dmitry131131/PumpSystem/Monitor/Readme.md

# Pump system monitor

## Release build

```bash
    cmake -G "Unix Makefiles" -S . -B build/Release -DCMAKE_BUILD_TYPE=Release

    cmake --build build/Release/
```
