dmitry131131/PumpSystem/PumpModule/3DModel/ForPrinting/MainParts.3mf

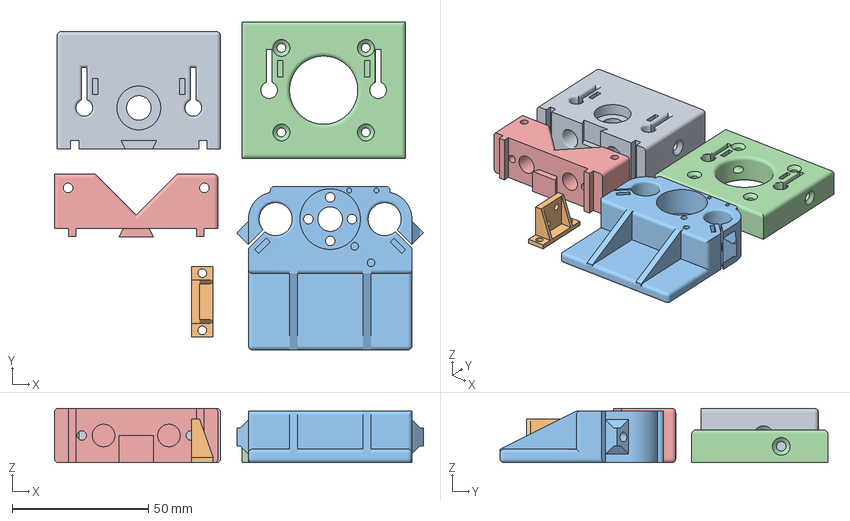
[picture p1: CAD file, 2026-09-05]
PumpModule/3DModel/ForPrinting/MainParts.3mf
135.4 x 120.3 x 20.0 mm
BackMount_magnetic.stp
CableChannelHolder.stp
Carriage_magnetic.stp
EngineMount.stp
MagneticSyringeHolder.stp
