dmitry131131/PumpSystem/MasterModule/3DModel/Под провода.stp

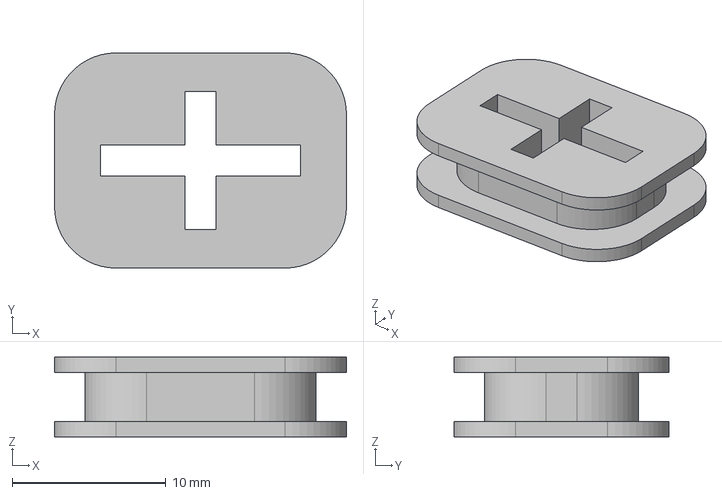
[picture p2: CAD file, 2026-06-11]
MasterModule/3DModel/Под провода.stp
19.0 x 14.0 x 5.20 mm
