dmitry131131/PumpSystem/PumpModule/3DModel/CableChannel/Hinge.STEP

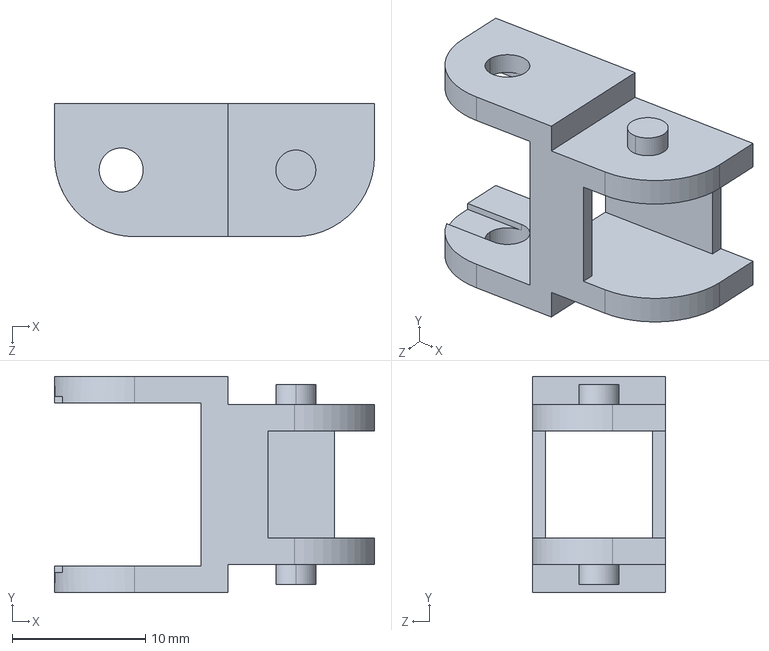
[picture p3: CAD file, 2026-07-20]
PumpModule/3DModel/CableChannel/Hinge.STEP
24.0 x 16.2 x 10.0 mm
