dmitry131131/PumpSystem/PumpModule/3DModel/ForPrinting/SpringeBackHolder.stp

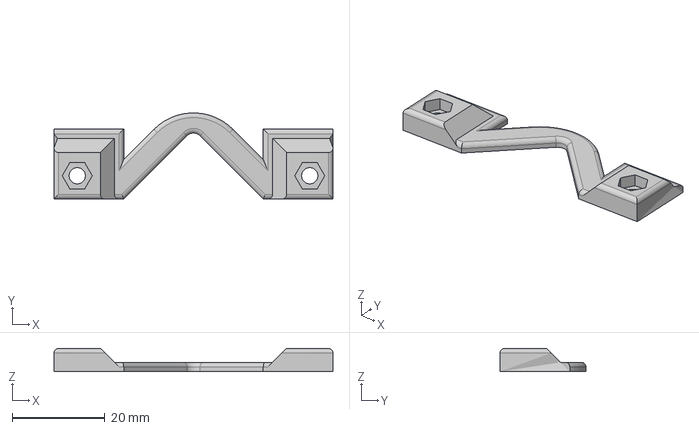
[picture p4: CAD file, 2026-09-05]
PumpModule/3DModel/ForPrinting/SpringeBackHolder.stp
60.0 x 18.5 x 5.00 mm
