dmitry131131/PumpSystem/MasterModule/3DModel/Прижим для UART.stp

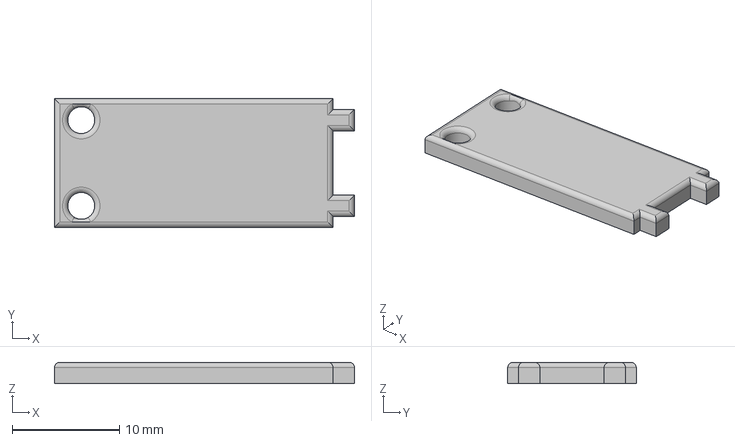
[picture p5: CAD file, 2026-06-11]
MasterModule/3DModel/Прижим для UART.stp
28.0 x 12.0 x 2.00 mm
