dmitry131131/PumpSystem/PumpModule/3DModel/CableChannel/HeadHinge.STEP

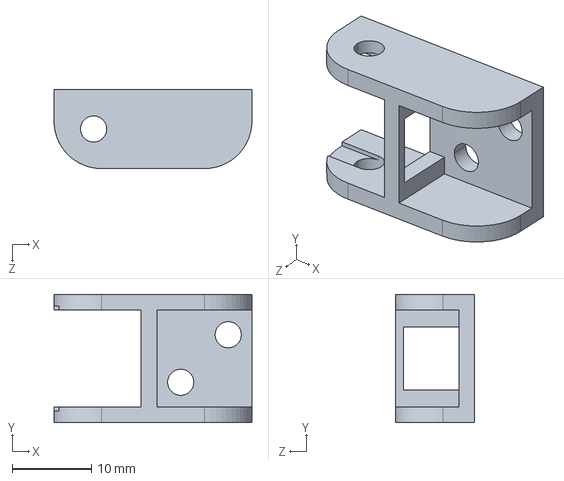
[picture p6: CAD file, 2026-07-20]
PumpModule/3DModel/CableChannel/HeadHinge.STEP
25.0 x 16.2 x 10.0 mm
