dmitry131131/PumpSystem/PumpModule/3DModel/ForPrinting/SyringeHolderHuge.stp

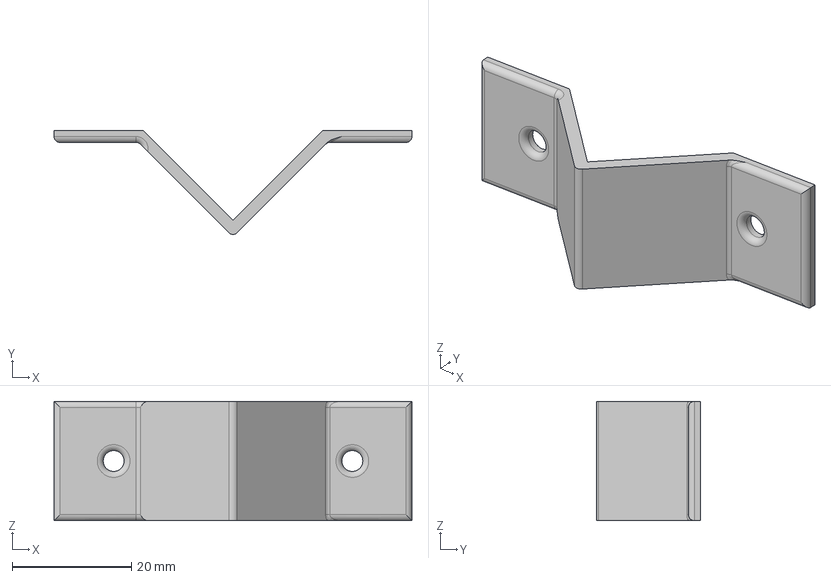
[picture p7: CAD file, 2026-09-05]
PumpModule/3DModel/ForPrinting/SyringeHolderHuge.stp
60.0 x 17.4 x 20.0 mm
