dmitry131131/PumpSystem/MasterModule/3DModel/Главная деталь корпуса.stp

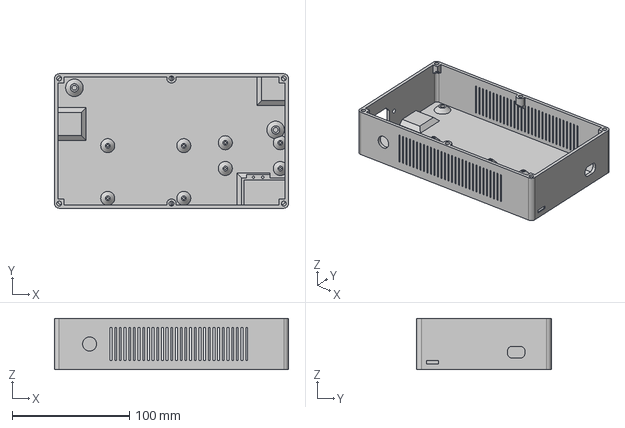
[picture p8: CAD file, 2026-06-11]
MasterModule/3DModel/Главная деталь корпуса.stp
200.0 x 115.0 x 44.0 mm
