dmitry131131/PumpSystem/PumpModule/3DModel/CableChannel/TailHinge.STEP

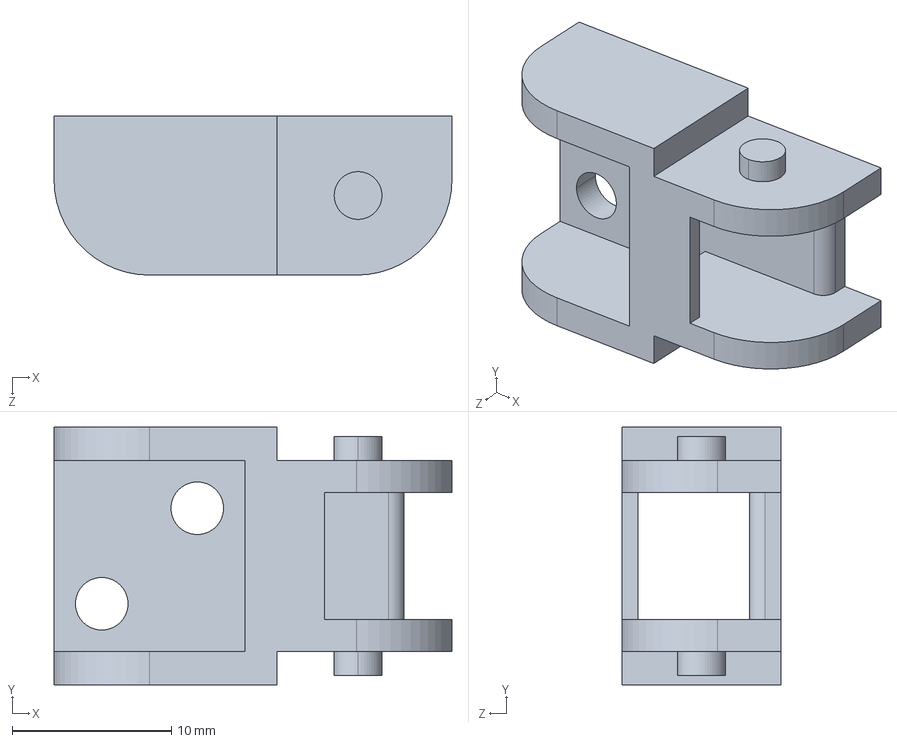
[picture p9: CAD file, 2026-07-20]
PumpModule/3DModel/CableChannel/TailHinge.STEP
25.0 x 16.2 x 10.0 mm
