dmitry131131/PumpSystem/MasterModule/3DModel/Крышка.stp

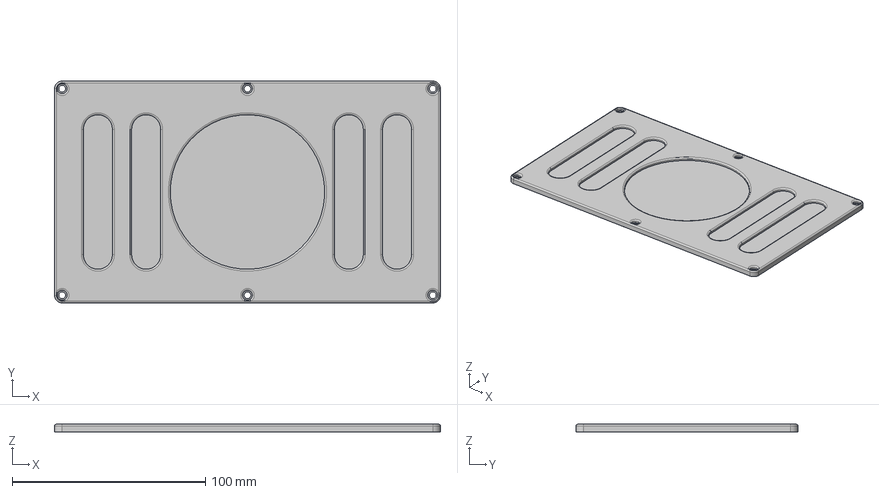
[picture p10: CAD file, 2026-06-11]
MasterModule/3DModel/Крышка.stp
200.0 x 115.0 x 4.00 mm
