dmitry131131/PumpSystem/PumpModule/3DModel/ForPrinting/SyringeHolderSmall.stp

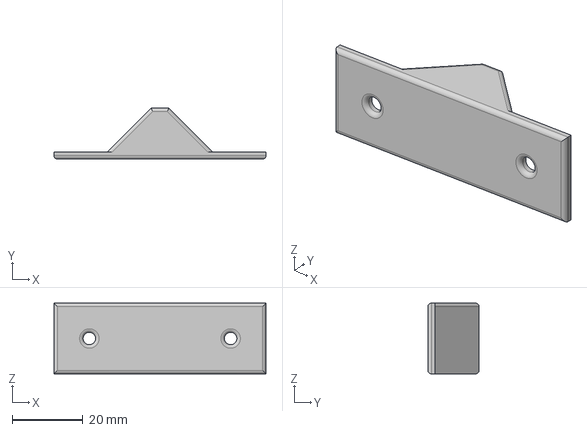
[picture p11: CAD file, 2026-09-05]
PumpModule/3DModel/ForPrinting/SyringeHolderSmall.stp
60.0 x 14.5 x 20.0 mm
