dmitry131131/PumpSystem/PumpModule/3DModel/ForPrinting/ElectricBox.stp

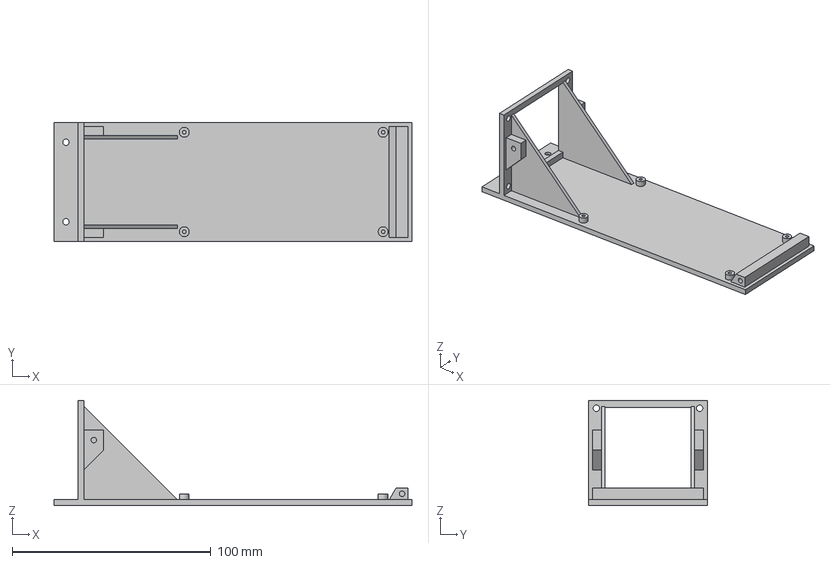
[picture p12: CAD file, 2026-09-05]
PumpModule/3DModel/ForPrinting/ElectricBox.stp
180.0 x 60.0 x 53.0 mm
