dmitry131131/PumpSystem/PumpModule/3DModel/ForPrinting/SyringeHolderMedium.stp

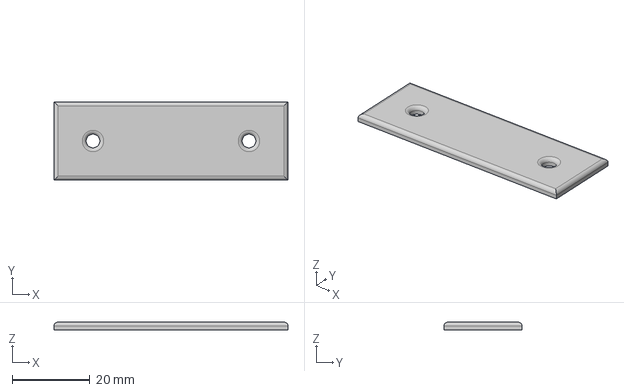
[picture p13: CAD file, 2026-09-05]
PumpModule/3DModel/ForPrinting/SyringeHolderMedium.stp
60.0 x 20.0 x 2.00 mm
