dmitry131131/PumpSystem/PumpModule/3DModel/ForPrinting/Stoper.stp

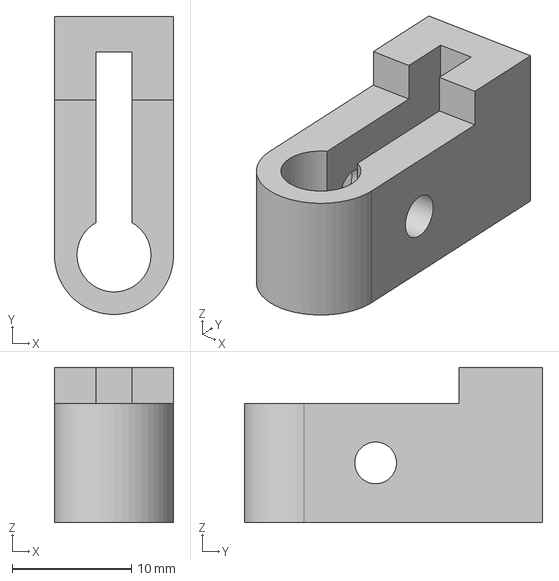
[picture p14: CAD file, 2026-09-05]
PumpModule/3DModel/ForPrinting/Stoper.stp
10.0 x 25.0 x 13.0 mm
