dmitry131131/PumpSystem/PumpModule/3DModel/ForPrinting/BackMount_magnetic.stp

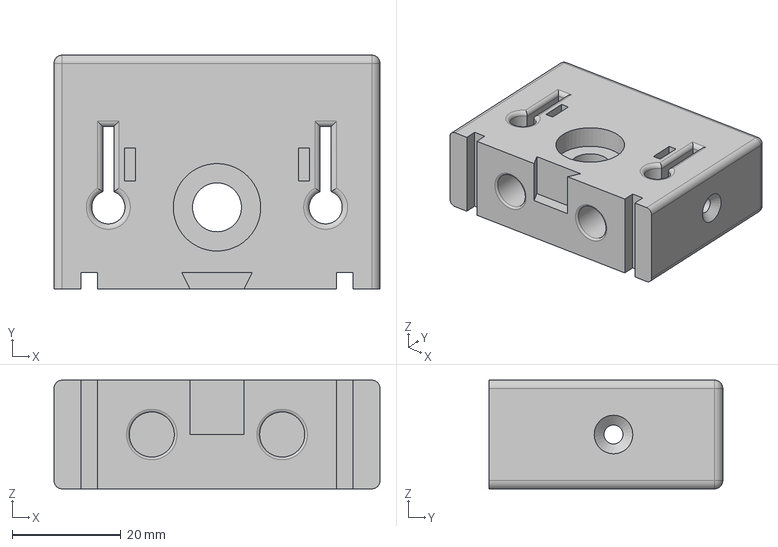
[picture p15: CAD file, 2026-09-05]
PumpModule/3DModel/ForPrinting/BackMount_magnetic.stp
60.0 x 43.0 x 20.0 mm
