dmitry131131/PumpSystem/PumpModule/3DModel/ForPrinting/CableChannel.3mf

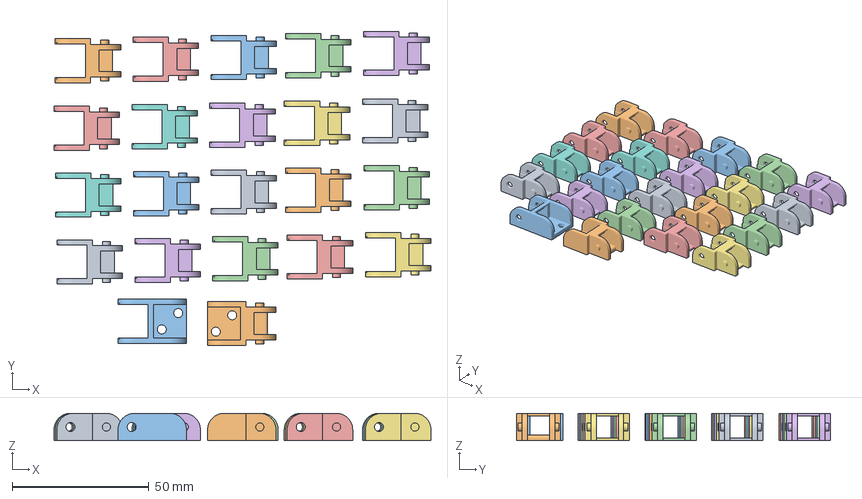
[picture p16: CAD file, 2026-09-05]
PumpModule/3DModel/ForPrinting/CableChannel.3mf
137.9 x 115.0 x 10.0 mm
Hinge.STEP x 20
TailHinge.STEP
HeadHinge.STEP
