dmitry131131/PumpSystem/PumpModule/3DModel/ForPrinting/SupportingElements.3mf

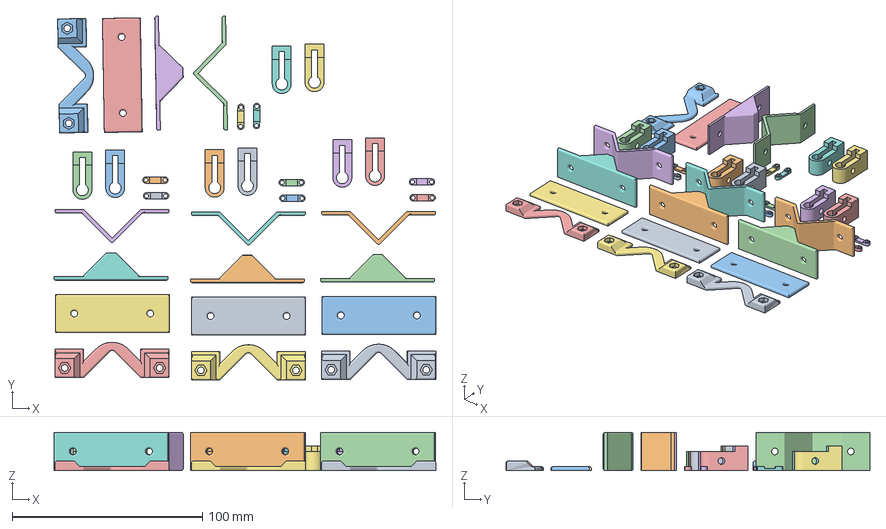
[picture p17: CAD file, 2026-09-05]
PumpModule/3DModel/ForPrinting/SupportingElements.3mf
200.9 x 191.4 x 20.0 mm
SpringeBackHolder.stp x 4
SyringeHolderHuge.stp x 4
SyringeHolderMedium.stp x 4
SyringeHolderSmall.stp x 4
WireHolder.stp x 8
Stoper.stp x 8
