dmitry131131/PumpSystem/PumpModule/3DModel/ForPrinting/ElectricBoxCup.stp

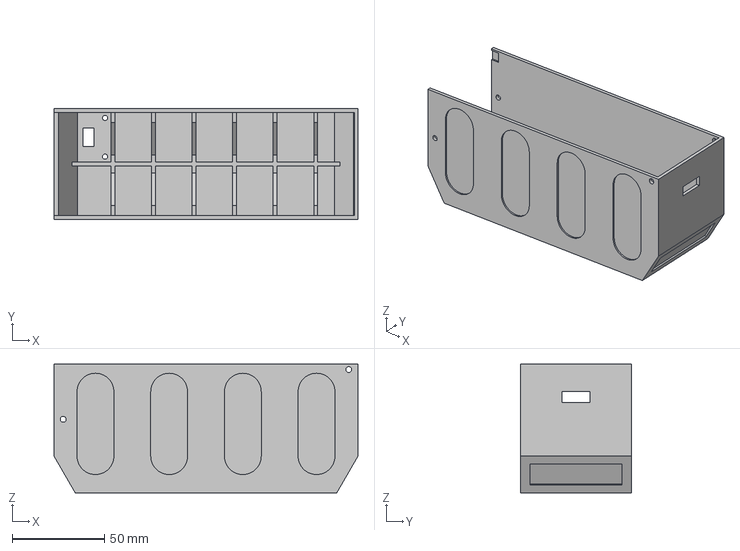
[picture p18: CAD file, 2026-09-05]
PumpModule/3DModel/ForPrinting/ElectricBoxCup.stp
165.0 x 60.0 x 70.0 mm
