dmitry131131/PumpSystem/PumpModule/3DModel/ForPrinting/EngineMount.stp

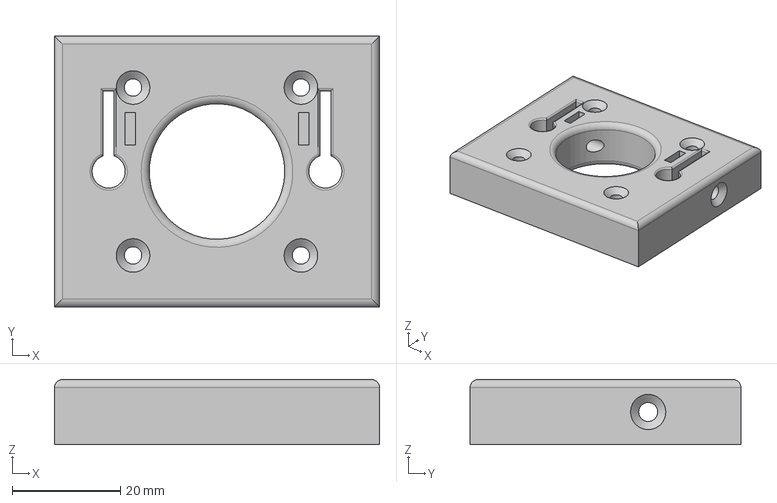
[picture p19: CAD file, 2026-09-05]
PumpModule/3DModel/ForPrinting/EngineMount.stp
60.0 x 50.0 x 12.0 mm
