dmitry131131/PumpSystem/PumpModule/3DModel/ForPrinting/WireHolder.stp

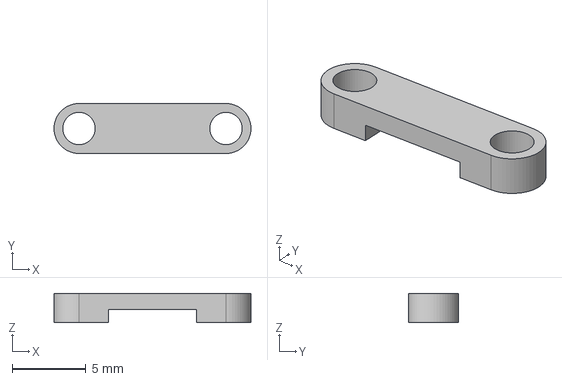
[picture p20: CAD file, 2026-07-20]
PumpModule/3DModel/ForPrinting/WireHolder.stp
13.4 x 3.40 x 2.00 mm
