dmitry131131/PumpSystem/PumpModule/3DModel/ForPrinting/Carriage_magnetic.stp

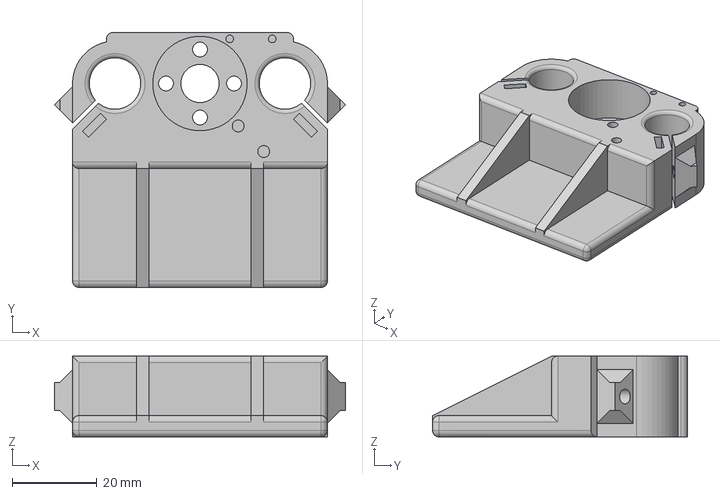
[picture p21: CAD file, 2026-07-20]
PumpModule/3DModel/ForPrinting/Carriage_magnetic.stp
68.5 x 60.0 x 19.0 mm
