dmitry131131/PumpSystem/PumpModule/3DModel/ForPrinting/MagneticSyringeHolder.stp

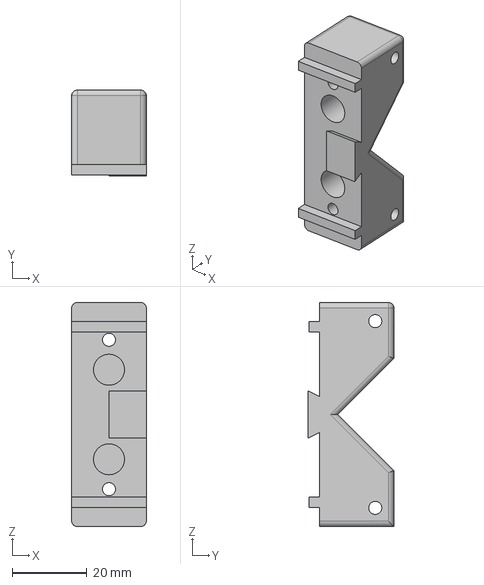
[picture p22: CAD file, 2026-07-20]
PumpModule/3DModel/ForPrinting/MagneticSyringeHolder.stp
20.0 x 23.0 x 60.0 mm
