dmitry131131/PumpSystem/PumpModule/3DModel/ForPrinting/CableChannelHolder.stp

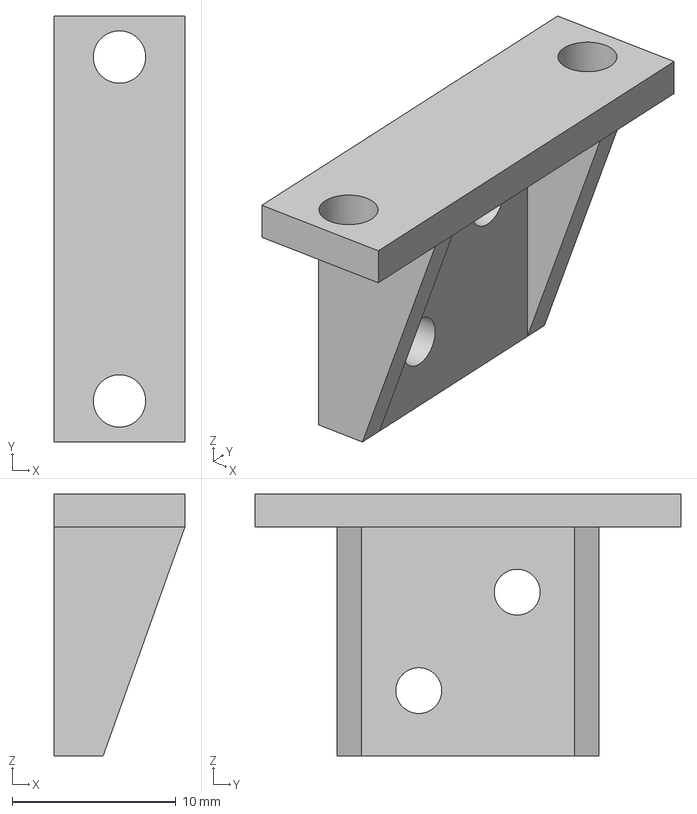
[picture p23: CAD file, 2026-07-20]
PumpModule/3DModel/ForPrinting/CableChannelHolder.stp
8.00 x 26.0 x 16.0 mm
