dmitry131131/PumpSystem/(list of files, cad)

Other CAD files:
MasterModule/3DModel/Главная деталь корпуса.3mf
MasterModule/3DModel/Крышка.3mf
MasterModule/3DModel/Под провода.3mf
PumpModule/3DModel/ForPrinting/BoltCap.3mf
PumpModule/3DModel/ForPrinting/BoltCap.stp
PumpModule/3DModel/ForPrinting/ElectricBox.3mf
PumpModule/3DModel/ForPrinting/Stoper.3mf
