dmitry131131/PumpSystem/PumpModule/3DModel/CableChannel/BuildExample.PNG

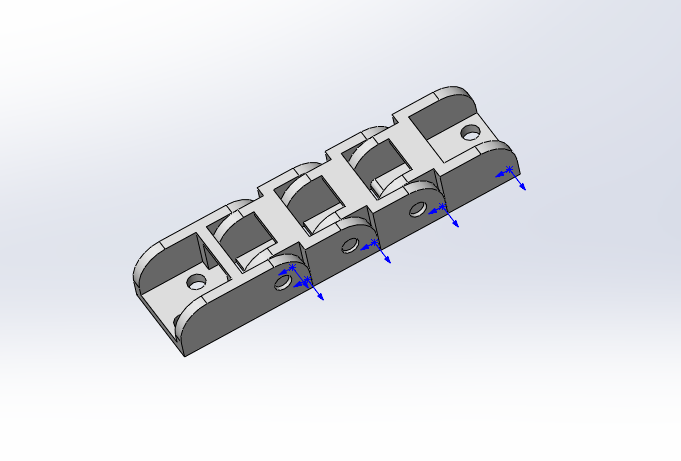
PumpModule/3DModel/CableChannel/BuildExample.PNG
