dmitry131131/PumpSystem/MasterModule/PCB/Bus/BusModule/_restore_backup_2026-05-27T22-22-10-652/BusModule-B_Cu.pdf

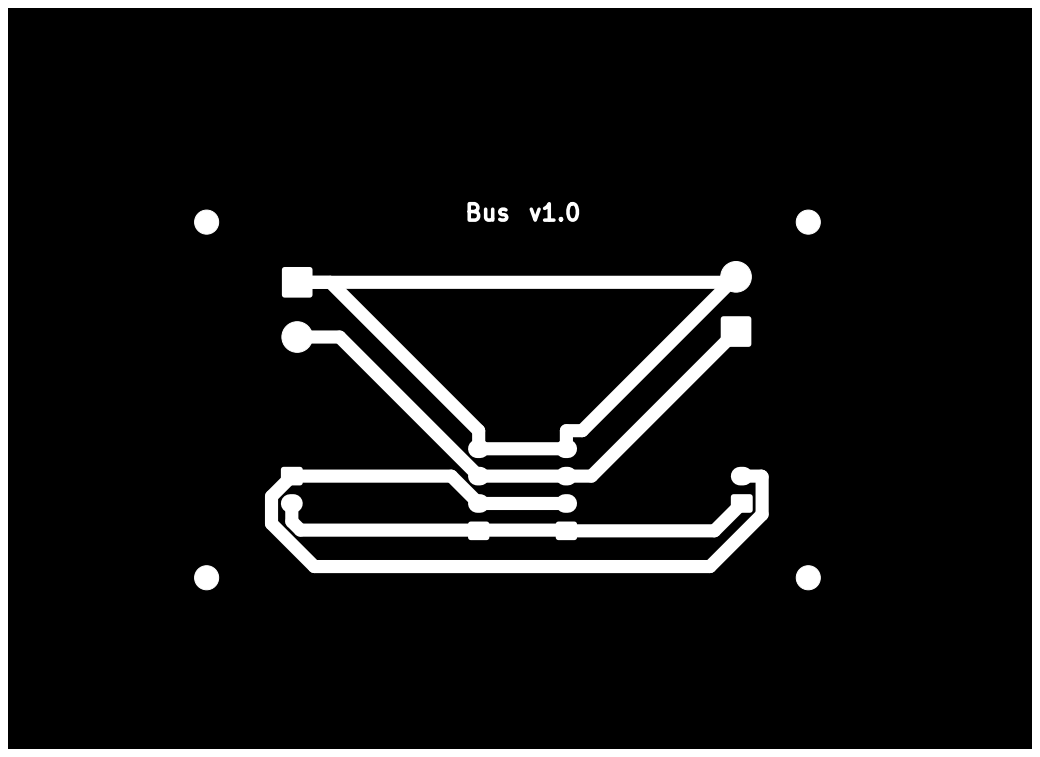
[picture p25: page 1]

Size: A4 | Rev:
KiCad E.D.A. 10.0.3 | Id: 1/1
