dmitry131131/PumpSystem/PumpModule/PCB/Manufacturing/PumpModule-B_Cu.pdf

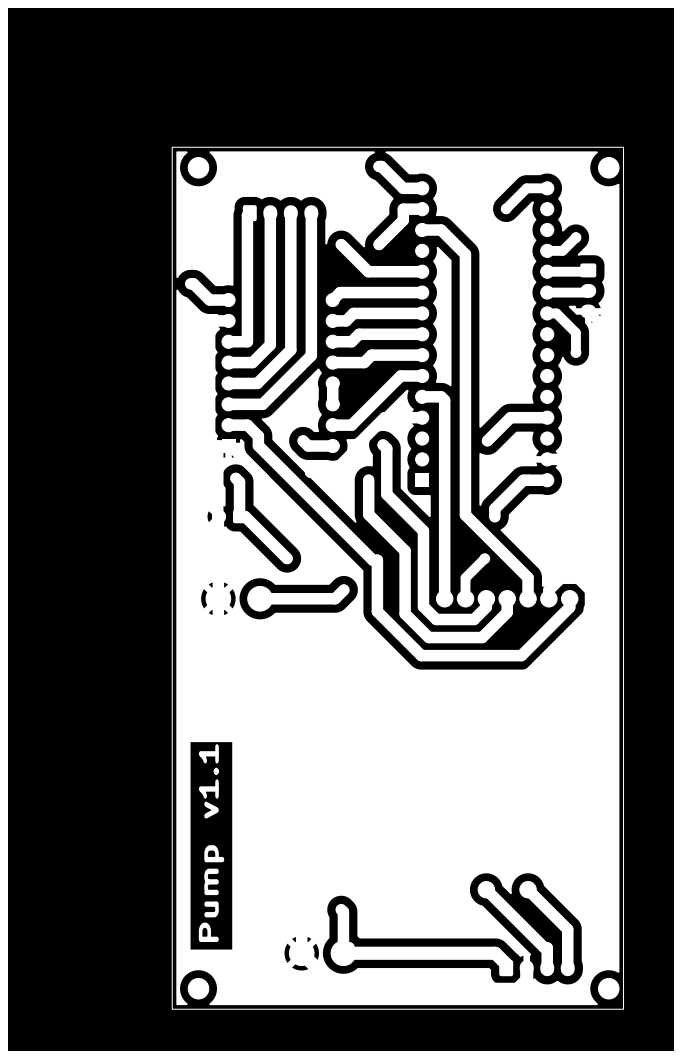
[picture p26: page 1]
