dmitry131131/PumpSystem/PumpModule/PCB/Manufacturing/PumpModule-B_Mask.pdf

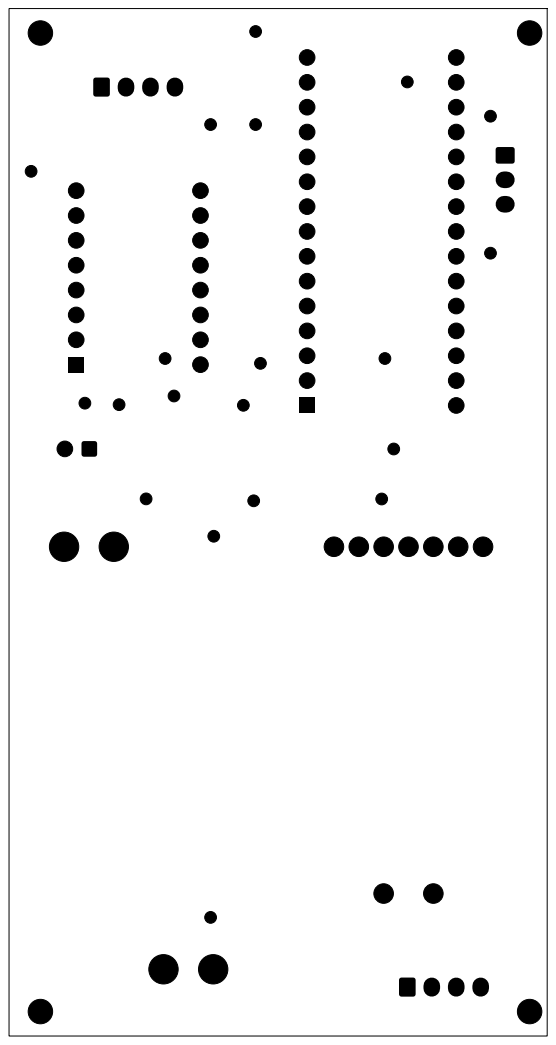
[picture p27: page 1]
