dmitry131131/PumpSystem/PumpModule/PCB/Manufacturing/PumpModule-F_Cu.pdf

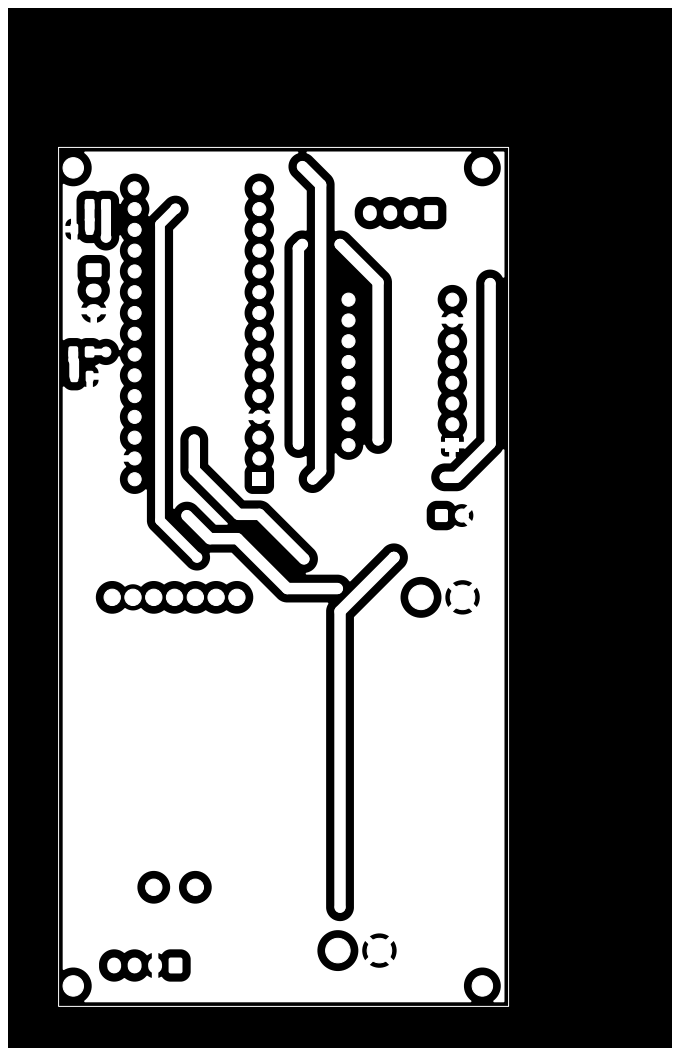
[picture p28: page 1]
