dmitry131131/PumpSystem/PumpModule/PCB/Manufacturing/PumpModule-F_Mask.pdf

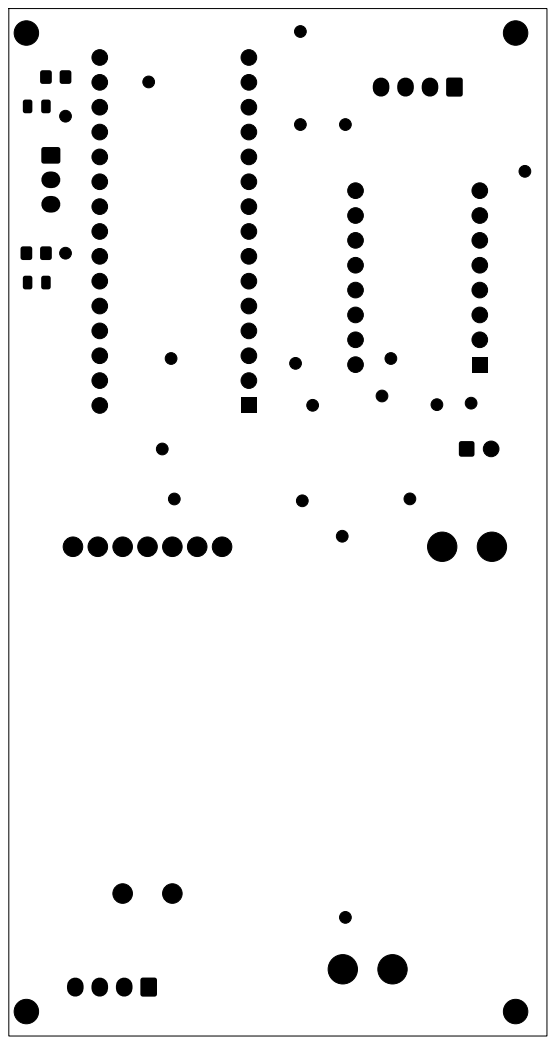
[picture p29: page 1]
