dmitry131131/PumpSystem/PumpModule/PCB/Manufacturing/PumpModule-F_Silkscreen.pdf

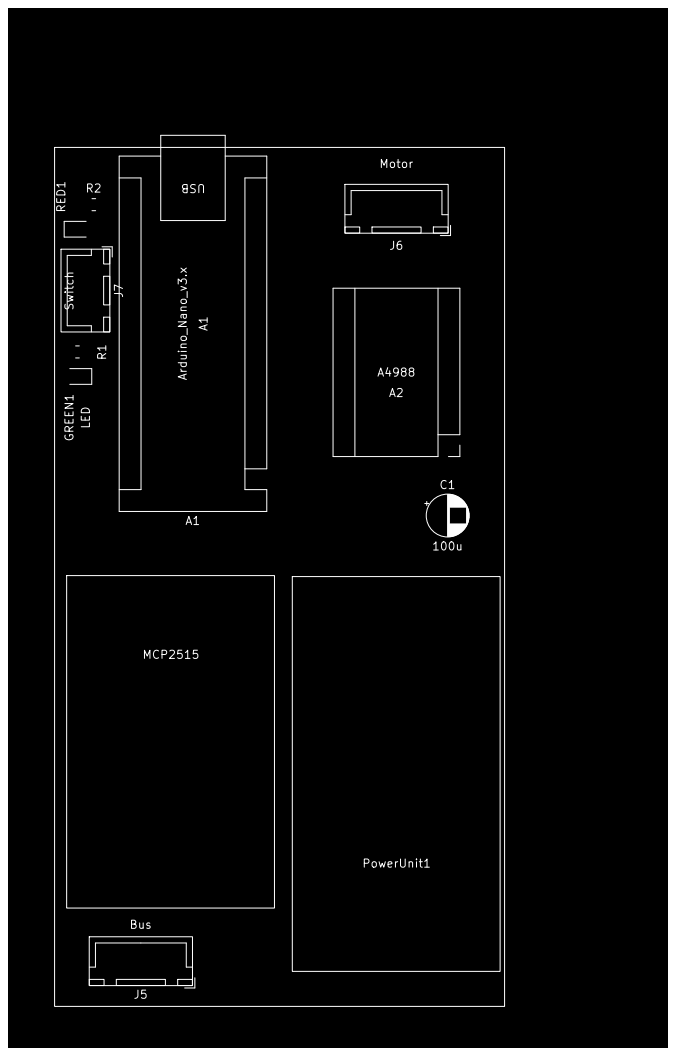
[picture p30: page 1]
