dmitry131131/PumpSystem/PumpModule/PCB/Switch/Manufacturing/Switch-B_Cu.pdf

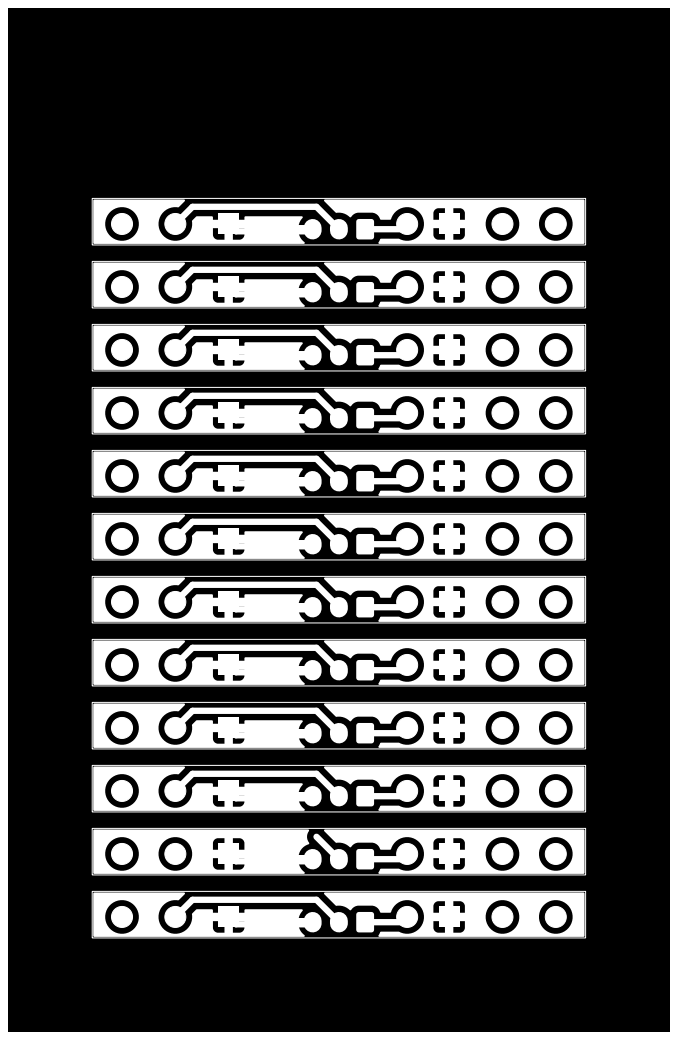
[picture p31: page 1]
