dmitry131131/PumpSystem/PumpModule/PCB/Switch/Manufacturing/Switch-B_Mask.pdf

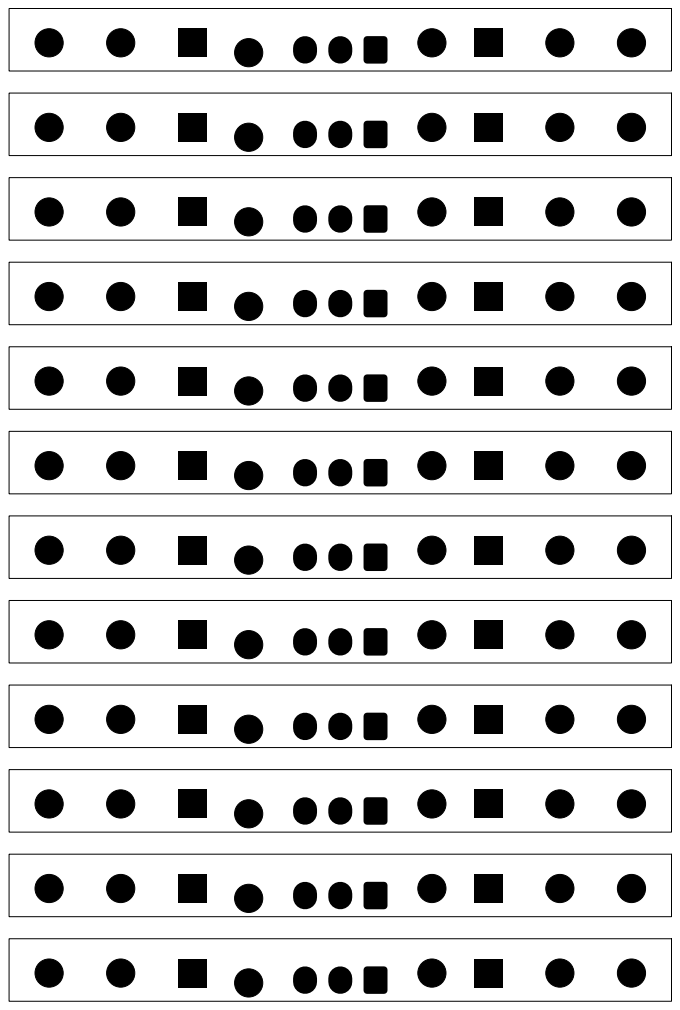
[picture p32: page 1]
