dmitry131131/PumpSystem/PumpModule/PCB/Switch/Manufacturing/Switch-F_Cu.pdf

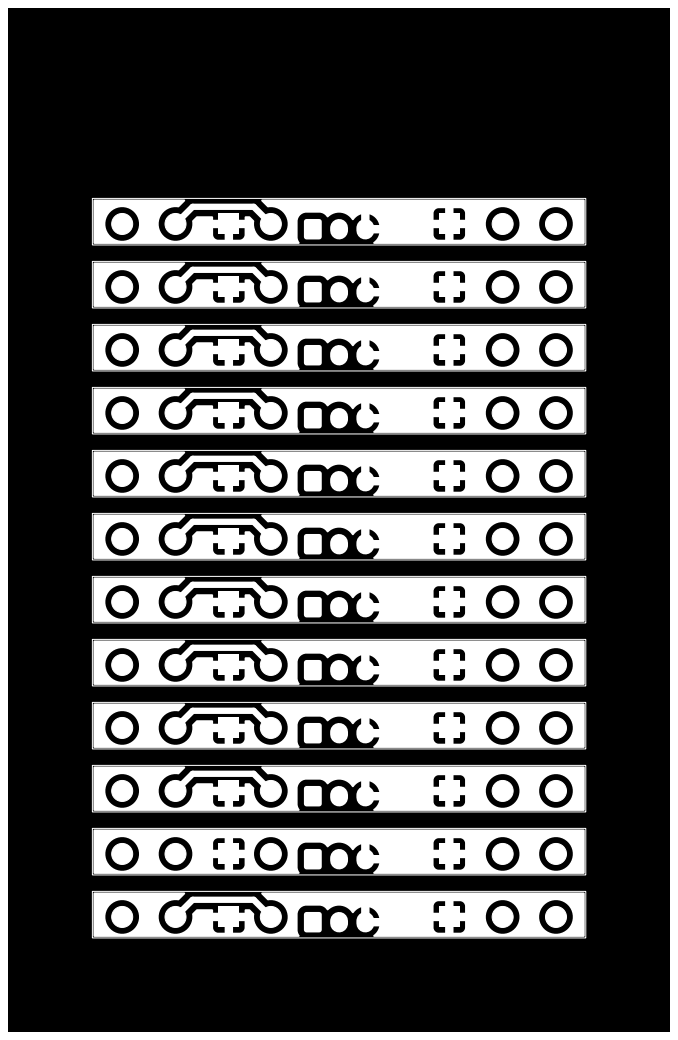
[picture p33: page 1]
