dmitry131131/PumpSystem/PumpModule/PCB/Switch/Manufacturing/Switch-F_Mask.pdf

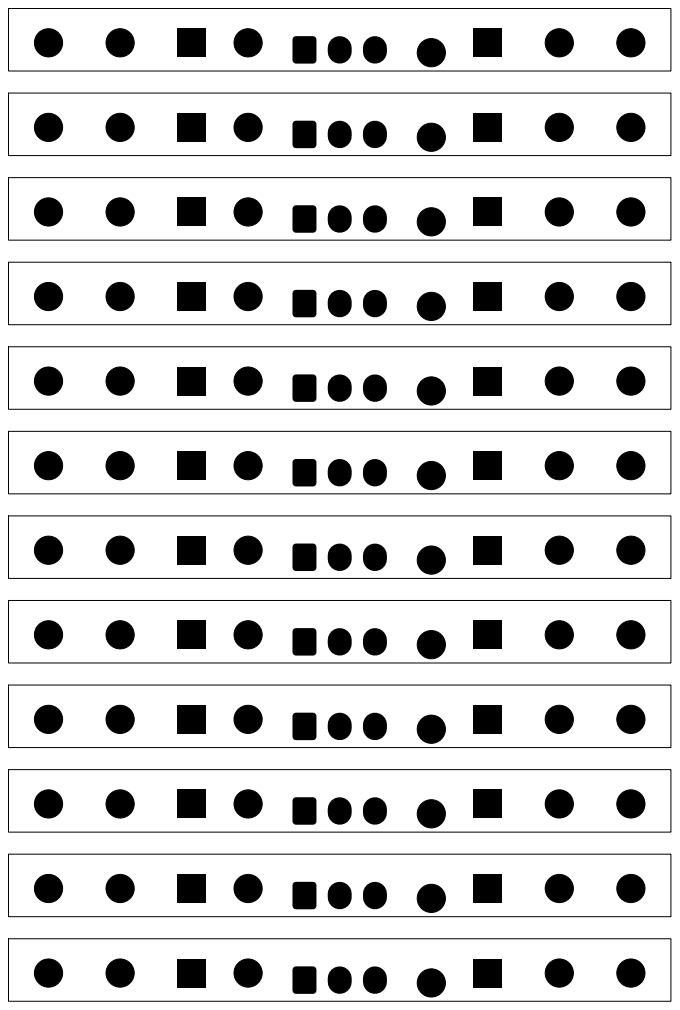
[picture p34: page 1]
