dmitry131131/PumpSystem/MasterModule/PCB/MasterModule/Manufacturing v1.1/MasterModule-B_Cu.pdf

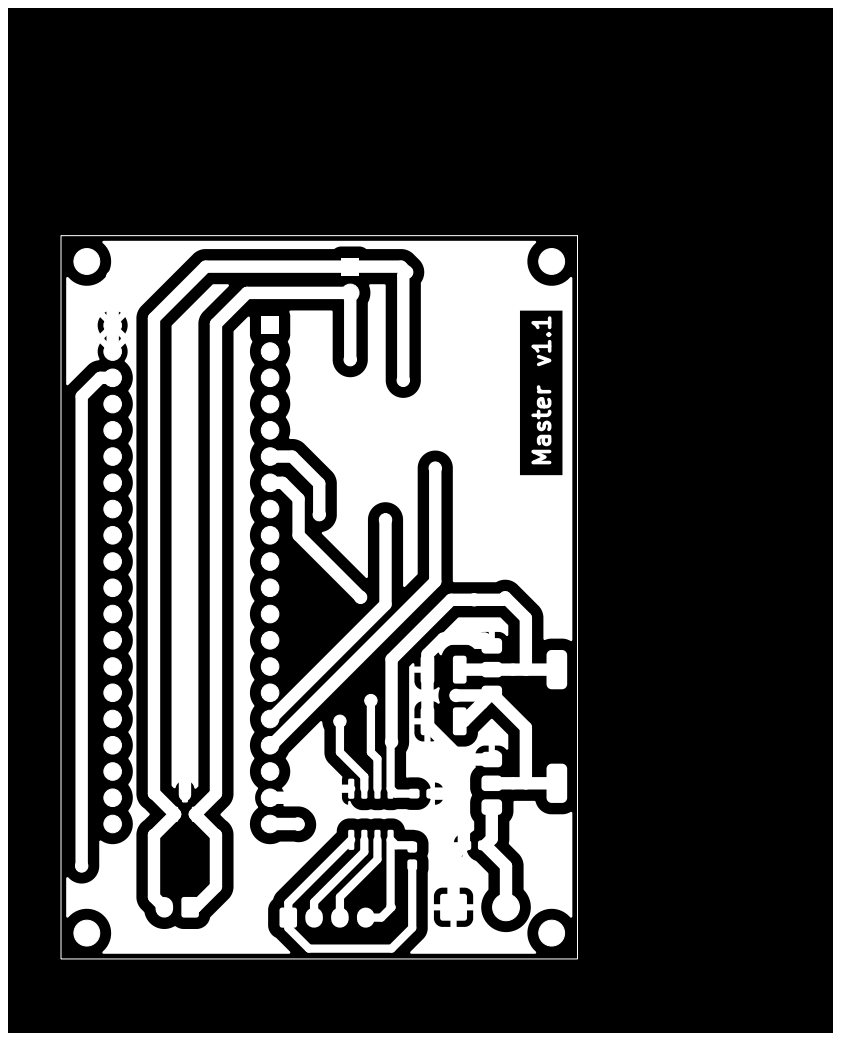
[picture p35: page 1]
