dmitry131131/PumpSystem/MasterModule/PCB/MasterModule/Manufacturing v1.1/MasterModule-F_Cu.pdf

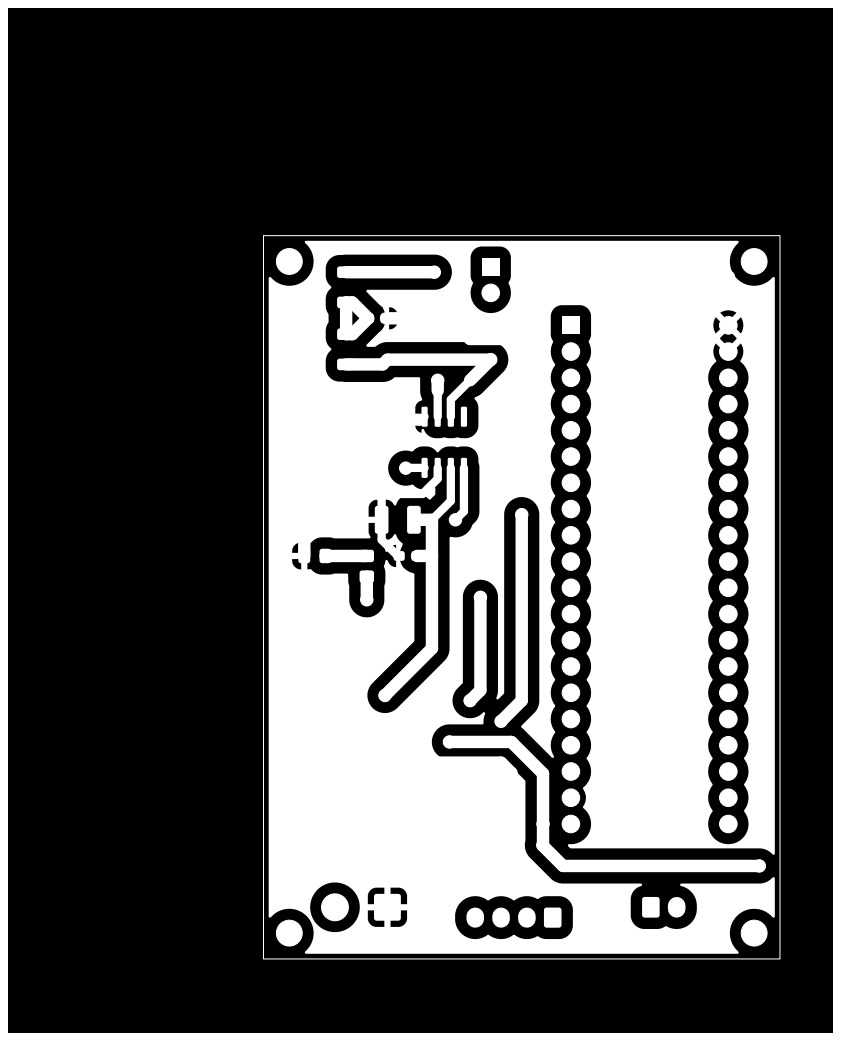
[picture p36: page 1]
