dmitry131131/PumpSystem/MasterModule/PCB/Bus/BusModule/Manufacturing/BusModule-B_Cu.pdf

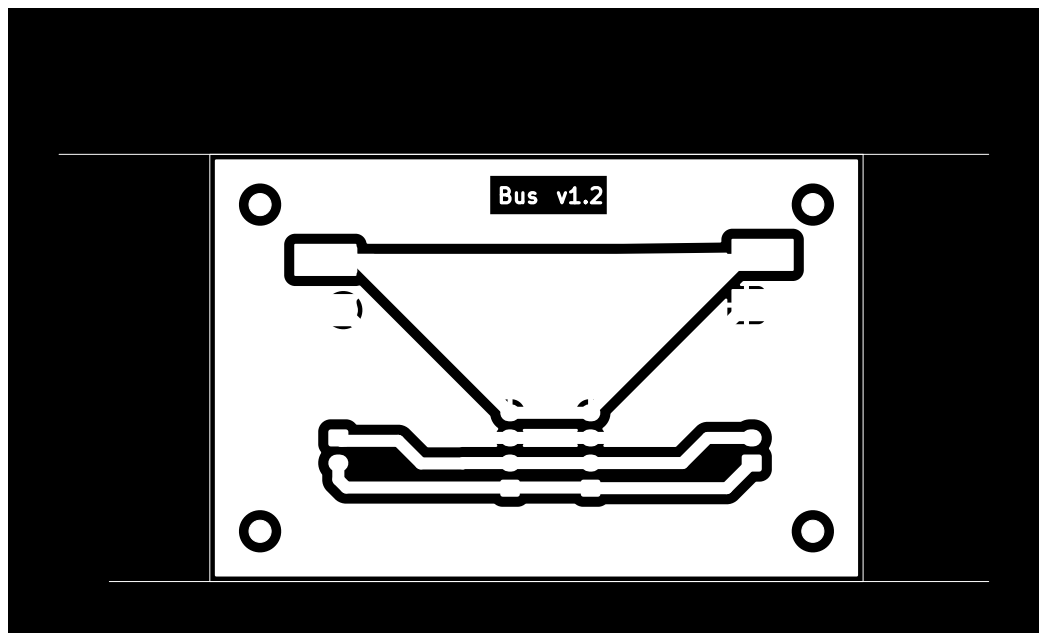
[picture p37: page 1]
