dmitry131131/PumpSystem/MasterModule/PCB/Bus/BusModule/Manufacturing/BusModule-B_Mask.pdf

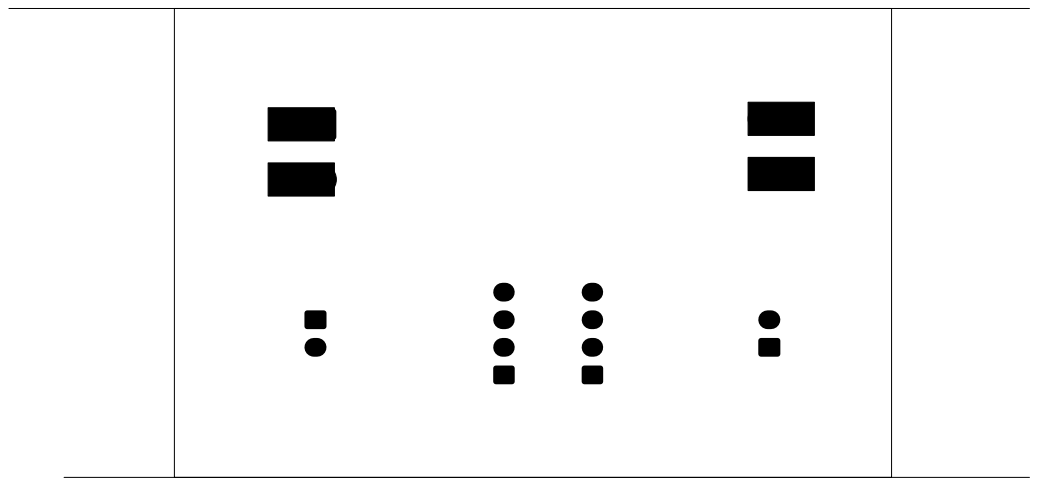
[picture p38: page 1]
