dmitry131131/PumpSystem/MasterModule/PCB/Bus/BusModule/Manufacturing/BusModule-F_Silkscreen.pdf

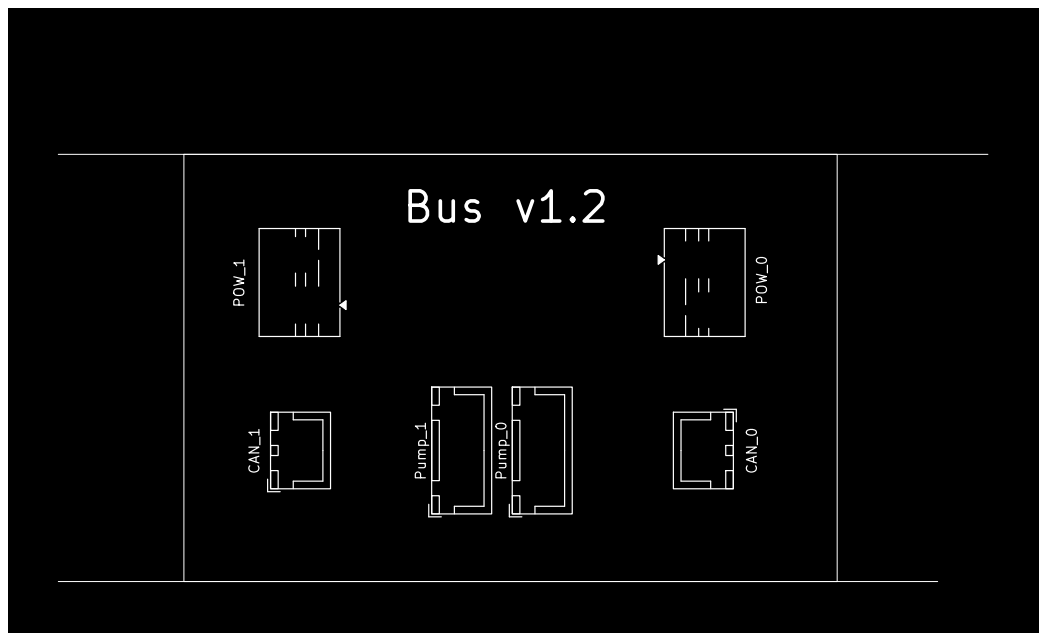
[picture p39: page 1]
