dmitry131131/PumpSystem/MasterModule/PCB/Bus/BusModule/_restore_backup_2026-05-27T22-22-10-652/Manufacturing/BusModule-B_Cu.pdf

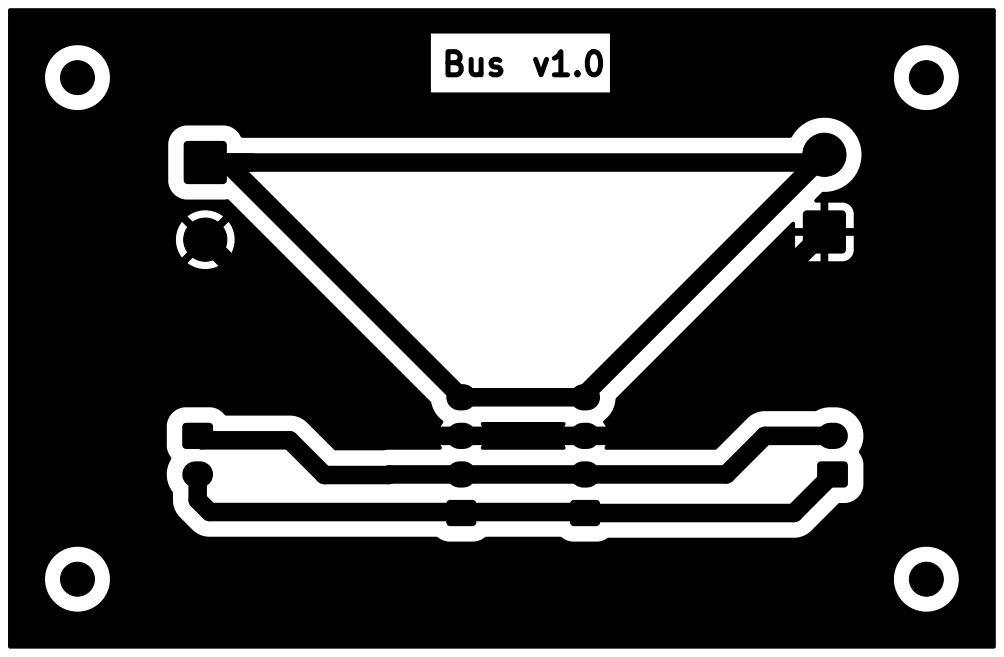
[picture p40: page 1]
