dmitry131131/PumpSystem/MasterModule/PCB/Bus/BusModule/_restore_backup_2026-05-27T22-22-10-652/Manufacturing/BusModule-F_Silkscreen.pdf

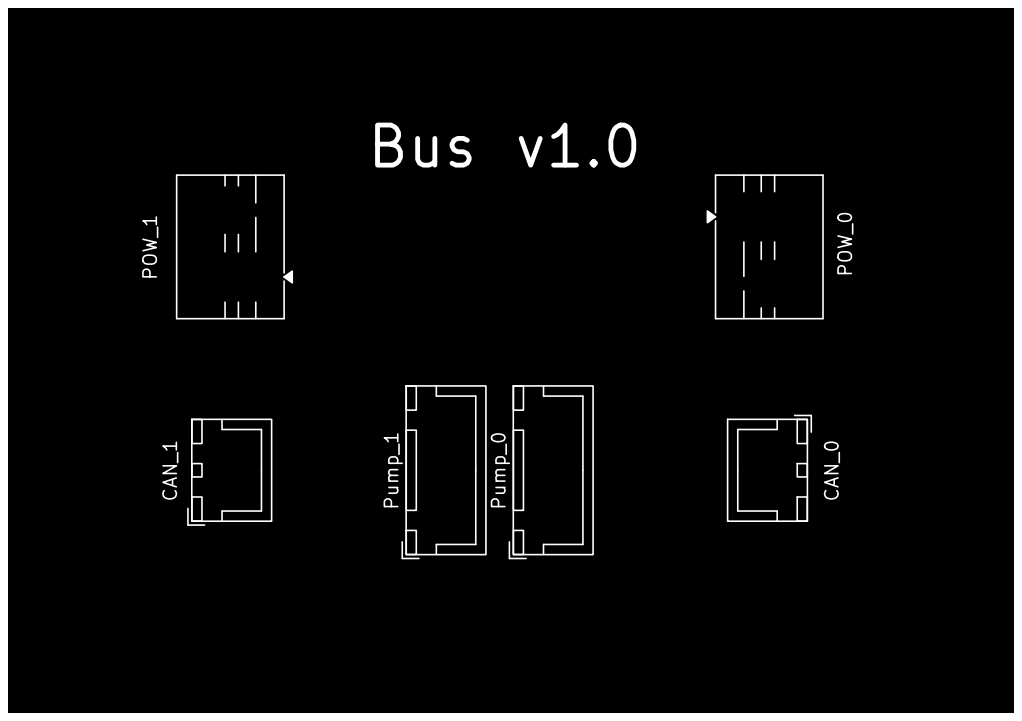
[picture p42: page 1]
