dmitry131131/PumpSystem/MasterModule/PCB/Bus/BusModule/Manufacturing/Bus v1.1 pair/BusModule-B_Cu.pdf

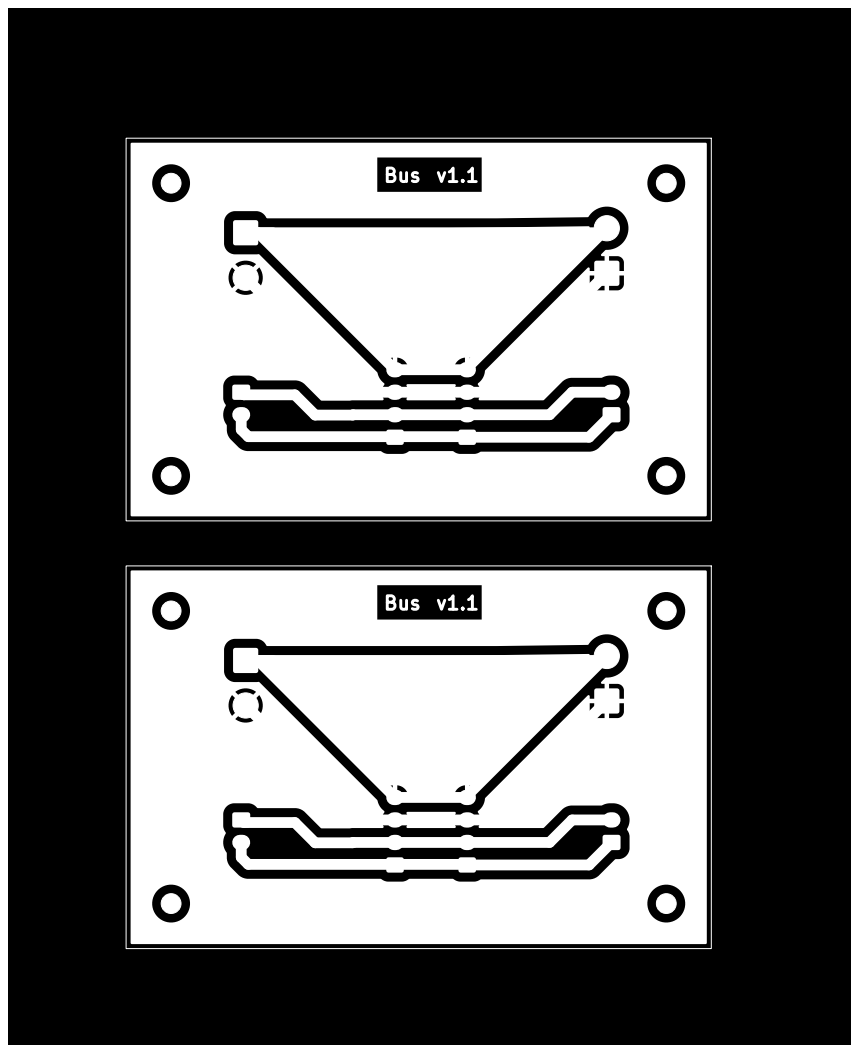
[picture p43: page 1]
