dmitry131131/PumpSystem/MasterModule/PCB/Bus/BusModule/Manufacturing/Bus v1.1 pair/BusModule-B_Mask.pdf

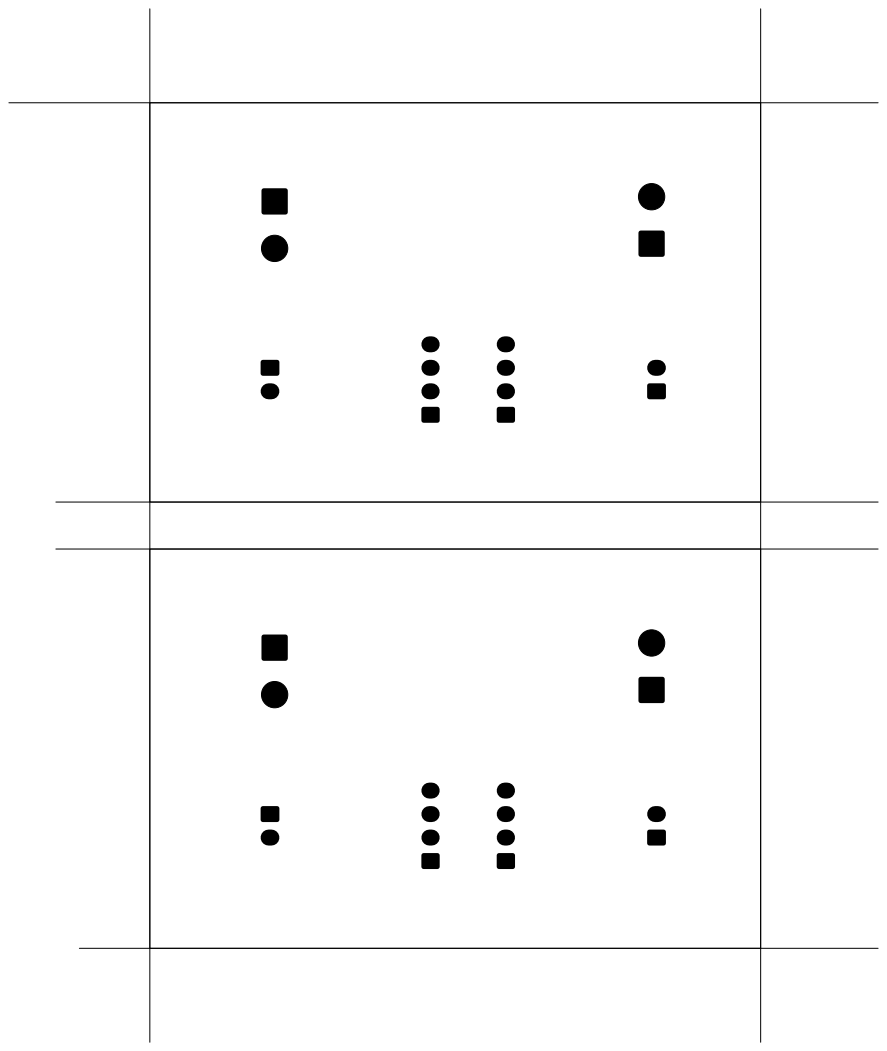
[picture p44: page 1]
