dmitry131131/PumpSystem/MasterModule/PCB/Bus/BusModule/Manufacturing/Bus v1.1 pair/BusModule-F_Silkscreen.pdf

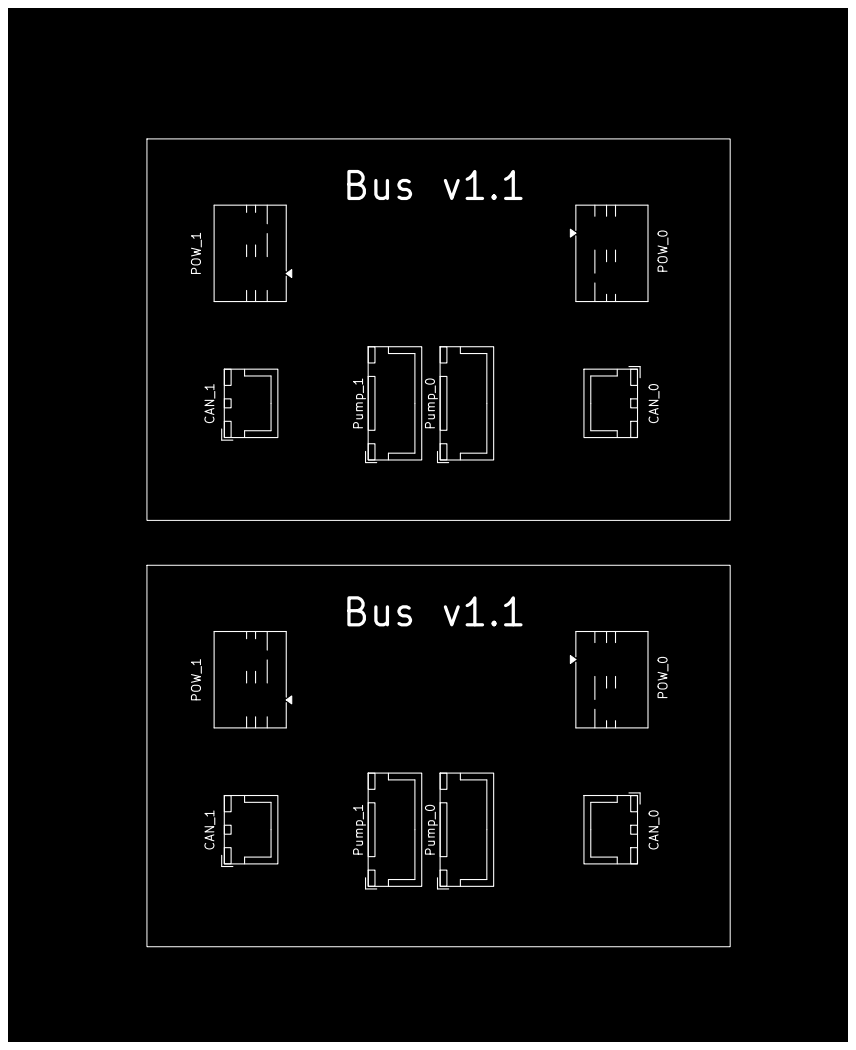
[picture p45: page 1]
