dmitry131131/PumpSystem/PumpModule/PCB/PumpModule/PumpModule.kicad_pcb

## KiCad design PumpModule/PCB/PumpModule/PumpModule.kicad_pcb (2026-09-05)

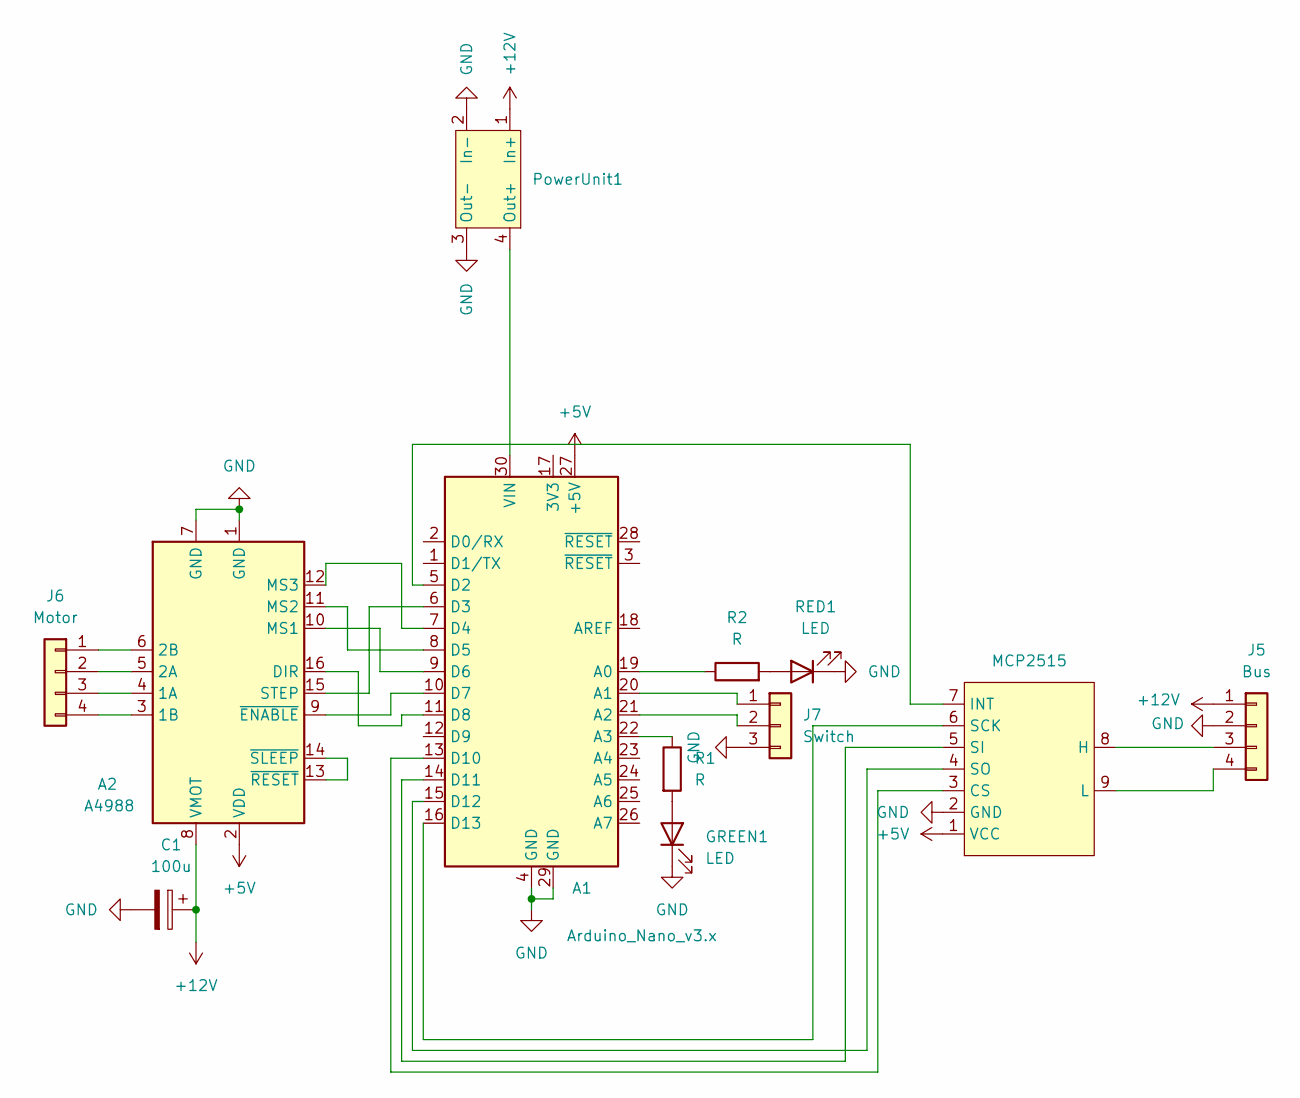
[picture p46: schematic PumpModule.kicad_sch]

Parts:
A1: Arduino_Nano_v3.x; Arduino_Nano
A2: A4988; Pololu_Breakout-16_15.2x20.3mm
C1: 100u; CP_Radial_D5.0mm_P2.50mm
GREEN1: LED; LED_0805_2012Metric
J5: Bus; JST_XH_B4B-XH-A_1x04_P2.50mm_Vertical
J6: Motor; JST_XH_B4B-XH-A_1x04_P2.50mm_Vertical
J7: Switch; JST_XH_B3B-XH-A_1x03_P2.50mm_Vertical
MCP2515: MCP2515Mudule
PowerUnit1: DC-DC_Low
R1, R2: R; R_0805_2012Metric_Pad1.20x1.40mm_HandSolder
RED1: LED; LED_0805_2012Metric

Connections:
+5V: A1.27 (+5V), A2.2 (VDD), MCP2515.1 (VCC)
+12V: A2.8 (VMOT), C1.1, J5.1, PowerUnit1.1 (In+)
GND: A1.4 (GND), A1.29 (GND), A2.1 (GND), A2.7 (GND), C1.2, GREEN1.1 (K), J5.2, J7.3, MCP2515.2 (GND), PowerUnit1.2 (In-), PowerUnit1.3 (Out-), RED1.1 (K)
unnamed: A1.19 (A0), R2.1
unnamed: A1.20 (A1), J7.1
unnamed: A1.21 (A2), J7.2
unnamed: A1.22 (A3), R1.1
unnamed: A1.5 (D2), MCP2515.7 (INT)
unnamed: A1.6 (D3), A2.15 (STEP)
unnamed: A1.7 (D4), A2.12 (MS3)
unnamed: A1.8 (D5), A2.11 (MS2)
unnamed: A1.9 (D6), A2.10 (MS1)
unnamed: A1.10 (D7), A2.9 (~ENABLE)
unnamed: A1.11 (D8), A2.16 (DIR)
unnamed: A1.13 (D10), MCP2515.3 (CS)
unnamed: A1.14 (D11), MCP2515.5 (SI)
unnamed: A1.15 (D12), MCP2515.4 (SO)
unnamed: A1.16 (D13), MCP2515.6 (SCK)
unnamed: A1.30 (VIN), PowerUnit1.4 (Out+)
unnamed: A2.4 (1A), J6.3
unnamed: A2.3 (1B), J6.4
unnamed: A2.5 (2A), J6.2
unnamed: A2.6 (2B), J6.1
unnamed: A2.13 (~RESET), A2.14 (~SLEEP)
unnamed: GREEN1.2 (A), R1.2
unnamed: J5.3, MCP2515.8 (H)
unnamed: J5.4, MCP2515.9 (L)
unnamed: R2.2, RED1.2 (A)

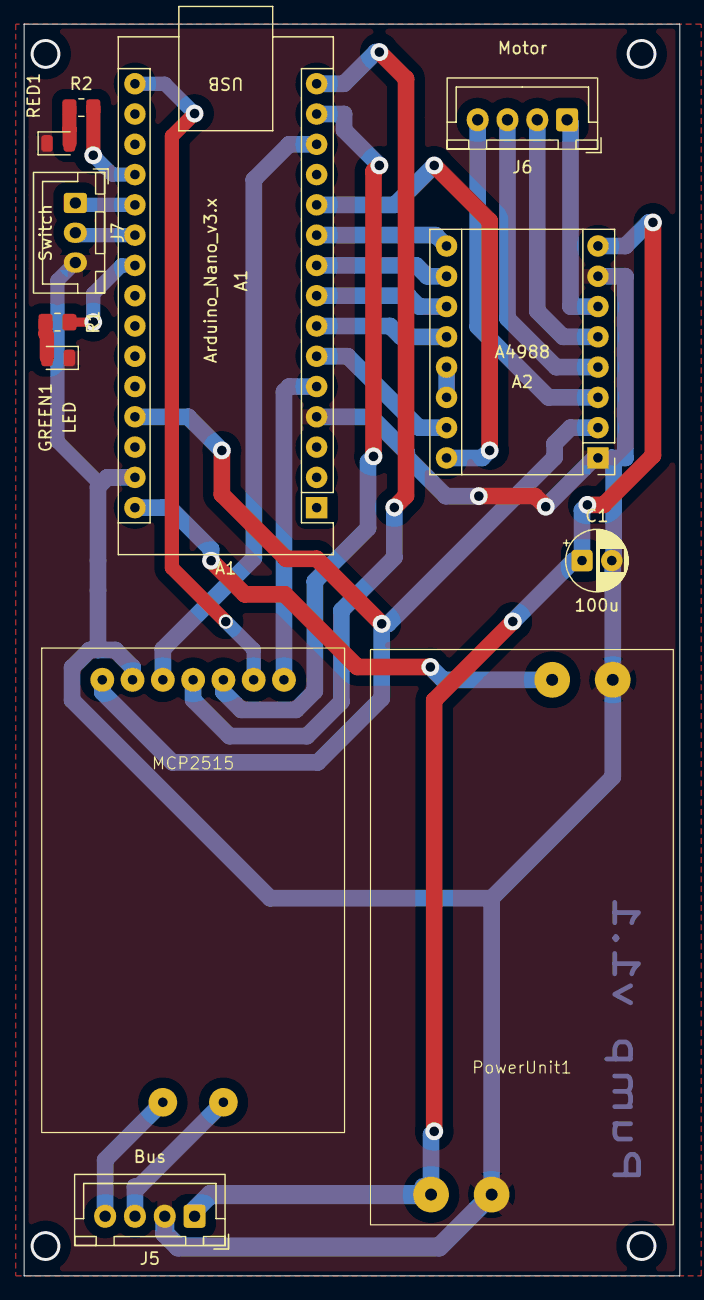
[picture p47: board PumpModule.kicad_pcb from above]

Board: 2 copper layers, 55.0 x 105.0 mm, 12 parts (0 on the bottom side), 28 nets.
