dmitry131131/PumpSystem/PumpModule/PCB/Switch/Switch.kicad_pcb

## KiCad design PumpModule/PCB/Switch/Switch.kicad_pcb (2026-07-29)

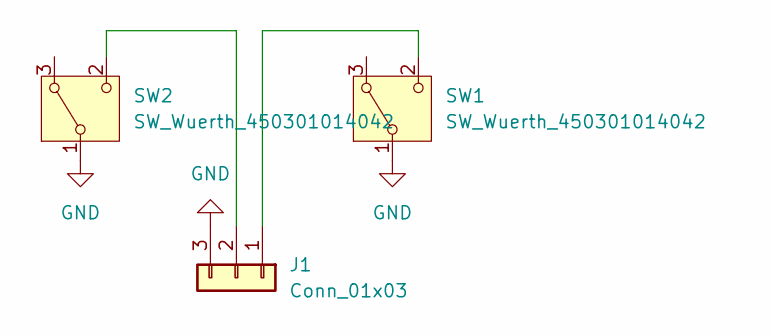
[picture p48: schematic Switch.kicad_sch]

Parts:
J1: Conn_01x03; JST_XH_B3B-XH-A_1x03_P2.50mm_Vertical
SW1, SW2: SW_Wuerth_450301014042; SW_XKB_DM1-16UC-1

Connections:
GND: J1.3, SW1.1 (B), SW2.1 (B)
unnamed: J1.1, SW1.2 (C)
unnamed: J1.2, SW2.2 (C)

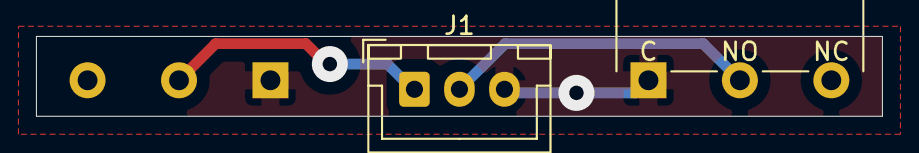
[picture p49: board Switch.kicad_pcb from above]

Board: 2 copper layers, 47.0 x 4.4 mm, 3 parts (1 on the bottom side), 3 nets.
