dmitry131131/PumpSystem/MasterModule/PCB/Bus/BusModule/_restore_backup_2026-05-27T22-22-10-652/BusModule.kicad_pcb

## KiCad design MasterModule/PCB/Bus/BusModule/_restore_backup_2026-05-27T22-22-10-652/BusModule.kicad_pcb (2026-07-20)

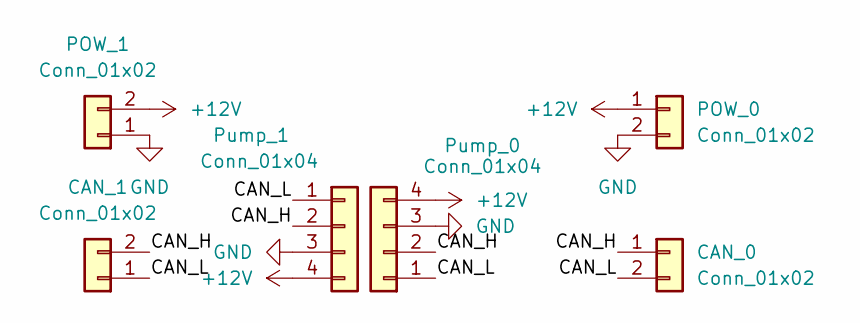
[picture p50: schematic BusModule.kicad_sch]

Parts:
CAN_0, CAN_1: Conn_01x02; JST_XH_B2B-XH-A_1x02_P2.50mm_Vertical
POW_0, POW_1: Conn_01x02; TerminalBlock_MaiXu_MX126-5.0-02P_1x02_P5.00mm
Pump_0, Pump_1: Conn_01x04; JST_XH_B4B-XH-A_1x04_P2.50mm_Vertical

Connections:
+12V: POW_0.1, POW_1.2, Pump_0.4, Pump_1.4
/CAN_H: CAN_0.1, CAN_1.2, Pump_0.2, Pump_1.2
/CAN_L: CAN_0.2, CAN_1.1, Pump_0.1, Pump_1.1
GND: POW_0.2, POW_1.1, Pump_0.3, Pump_1.3

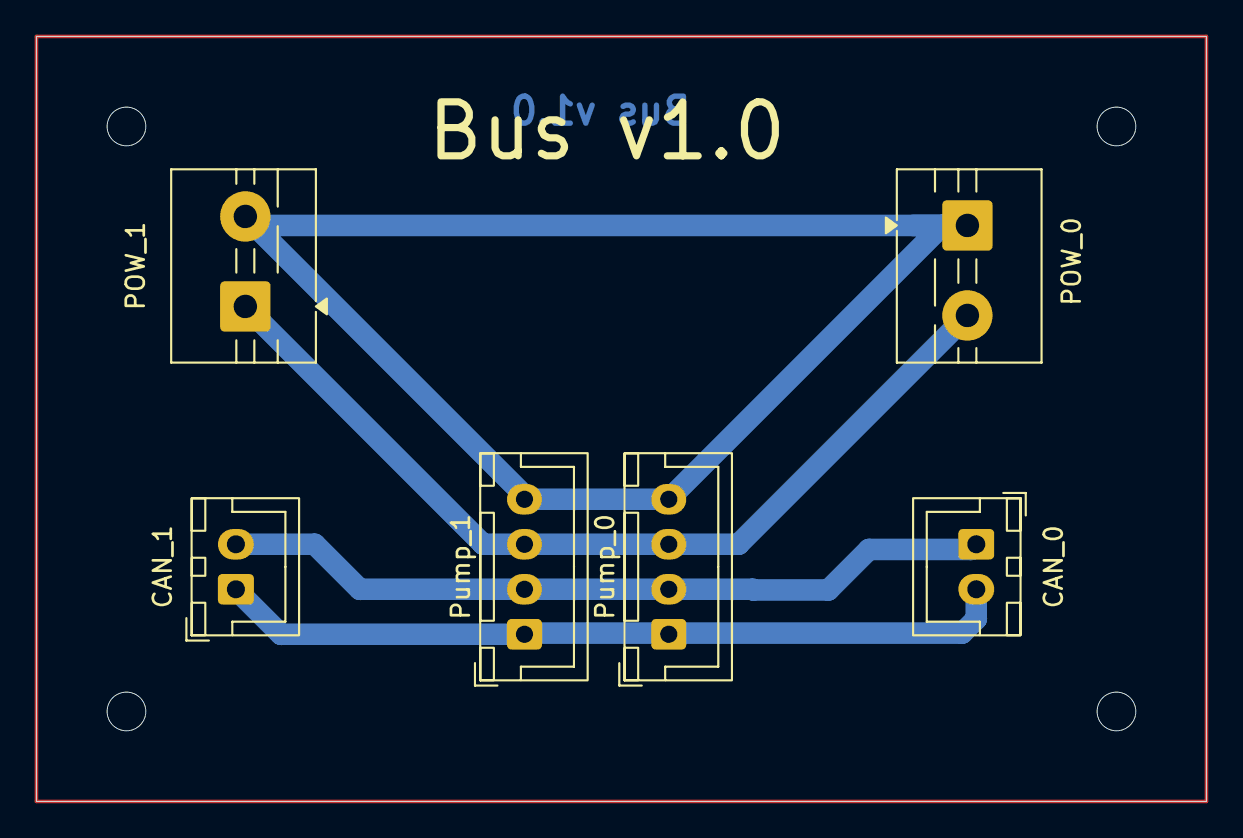
[picture p51: board BusModule.kicad_pcb from above]

Board: 2 copper layers, 65.0 x 42.5 mm, 6 parts (0 on the bottom side), 4 nets.
