dmitry131131/PumpSystem/MasterModule/PCB/MasterModule/MasterModule/MasterModule.kicad_pcb

## KiCad design MasterModule/PCB/MasterModule/MasterModule/MasterModule.kicad_pcb (2026-07-20)

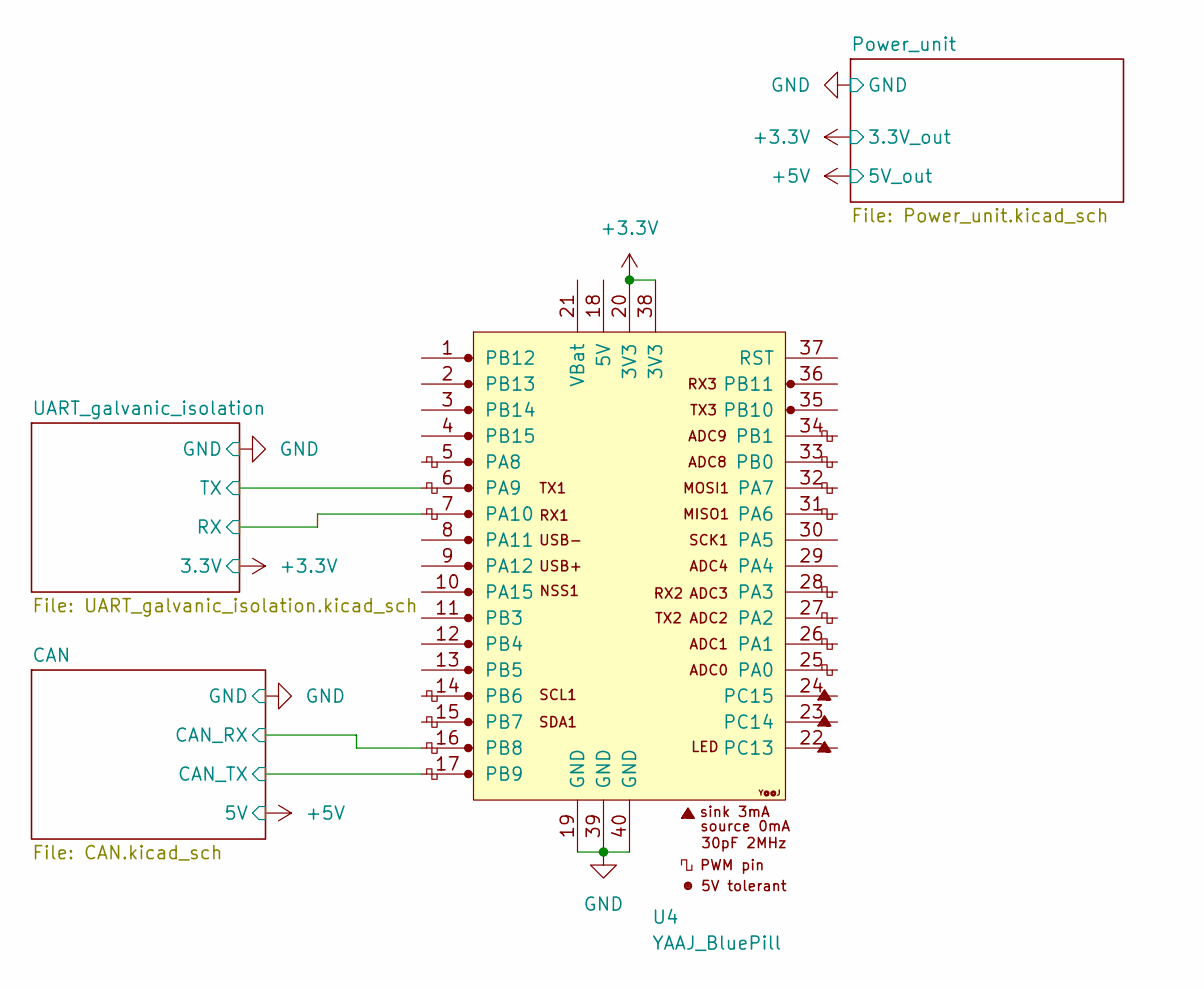
[picture p52: schematic MasterModule.kicad_sch]

Parts:
U4: YAAJ_BluePill; YAAJ_BluePill_1

Connections:
+3.3V: U4.20 (3V3), U4.38 (3V3); also elsewhere on the board
/CAN/CAN_RX: U4.16 (PB8); also elsewhere on the board
/CAN/CAN_TX: U4.17 (PB9); also elsewhere on the board
/UART_galvanic_isolation/RX: U4.7 (PA10); also elsewhere on the board
/UART_galvanic_isolation/TX: U4.6 (PA9); also elsewhere on the board
GND: U4.19 (GND), U4.39 (GND), U4.40 (GND); also elsewhere on the board

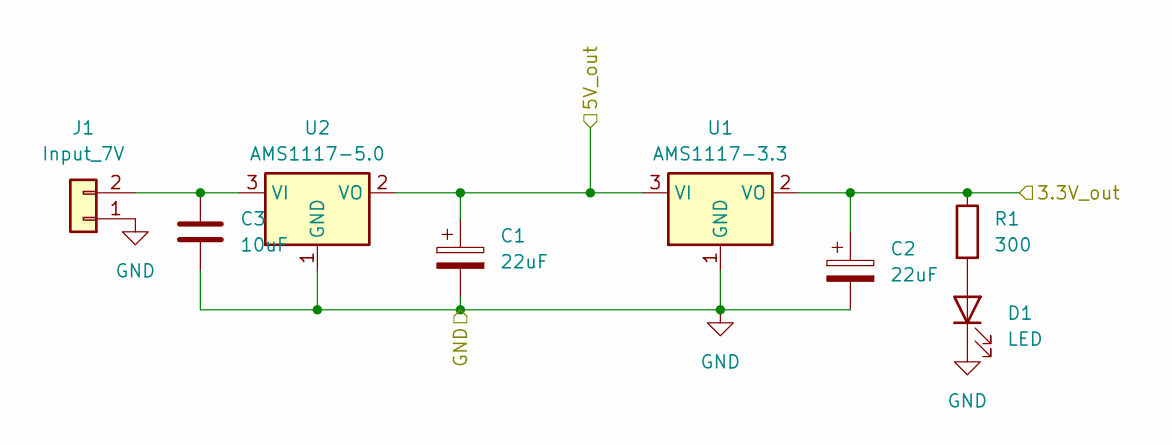
[picture p53: schematic Power_unit.kicad_sch]

Parts:
C1, C2: 22uF; C_1210_3225Metric_Pad1.33x2.70mm_HandSolder
C3: 10uF; C_0603_1608Metric_Pad1.08x0.95mm_HandSolder
D1: LED; LED_0805_2012Metric_Pad1.15x1.40mm_HandSolder
J1: Input_7V; TerminalBlock_Phoenix_MKDS-1,5-2-5.08_1x02_P5.08mm_Horizont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
R1: 300; R_0805_2012Metric_Pad1.20x1.40mm_HandSolder
U1: AMS1117-3.3; SOT-223-3_TabPin2
U2: AMS1117-5.0; SOT-223-3_TabPin2

Connections:
+3.3V: C2.1, R1.1, U1.2 (VO); also elsewhere on the board
+5V: C1.1, U1.3 (VI), U2.2 (VO); also elsewhere on the board
GND: C1.2, C2.2, C3.2, D1.1 (K), J1.1, U1.1 (GND), U2.1 (GND); also elsewhere on the board
unnamed: D1.2 (A), R1.2
unnamed: C3.1, J1.2, U2.3 (VI)

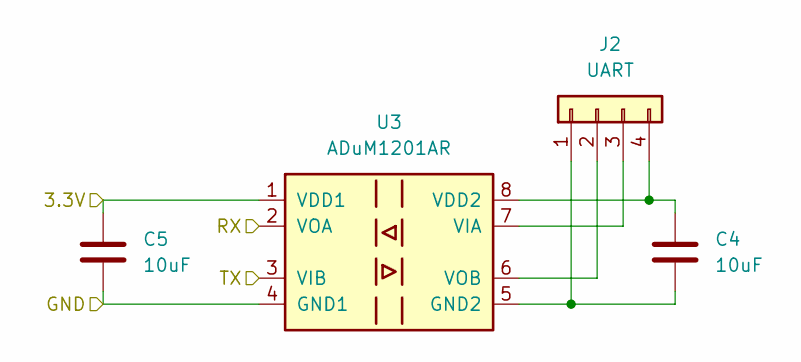
[picture p54: schematic UART_galvanic_isolation.kicad_sch]

Parts:
C4, C5: 10uF; C_0603_1608Metric_Pad1.08x0.95mm_HandSolder
J2: UART; JST_XH_B4B-XH-A_1x04_P2.50mm_Vertical
U3: ADuM1201AR; SOIC-8_3.9x4.9mm_P1.27mm

Connections:
+3.3V: C5.1, U3.1 (VDD1); also elsewhere on the board
/UART_galvanic_isolation/RX: U3.2 (VOA); also elsewhere on the board
/UART_galvanic_isolation/TX: U3.3 (VIB); also elsewhere on the board
GND: C5.2, U3.4 (GND1); also elsewhere on the board
unnamed: C4.2, J2.1, U3.5 (GND2)
unnamed: J2.2, U3.6 (VOB)
unnamed: J2.3, U3.7 (VIA)
unnamed: C4.1, J2.4, U3.8 (VDD2)

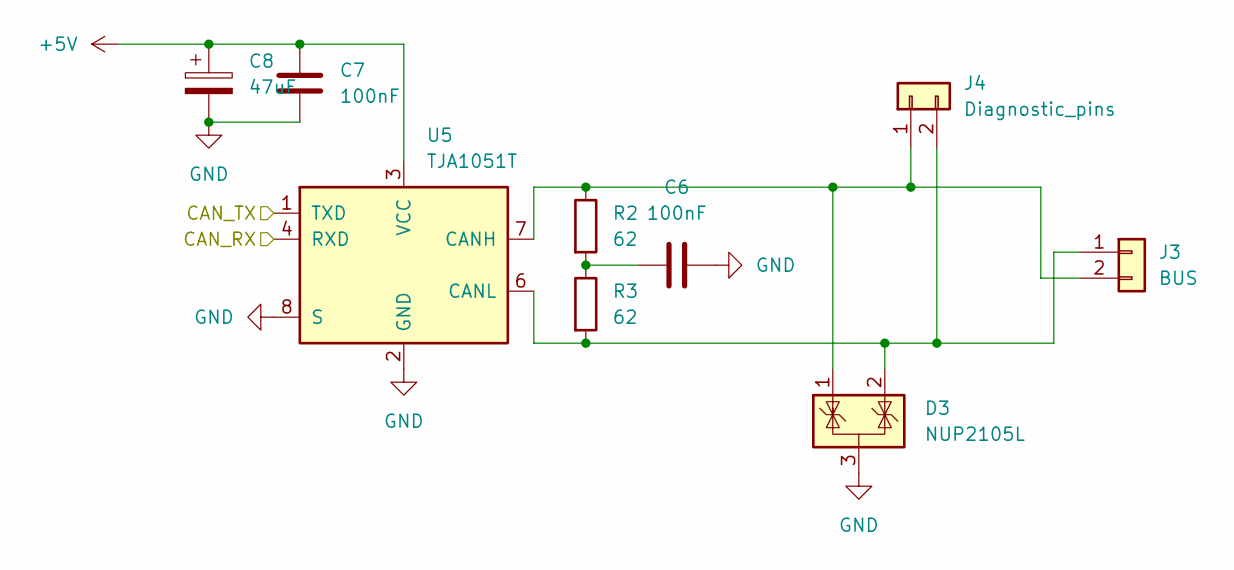
[picture p55: schematic CAN.kicad_sch]

Parts:
C6, C7: 100nF; C_0603_1608Metric_Pad1.08x0.95mm_HandSolder
C8: 47uF; C_1210_3225Metric_Pad1.33x2.70mm_HandSolder
D3: NUP2105L; SOT-23
J3: BUS; JST_XH_B2B-XH-A_1x02_P2.50mm_Vertical
J4: Diagnostic_pins; PinSocket_1x02_P2.54mm_Vertical
R2, R3: 62; R_1206_3216Metric
U5: TJA1051T; SOIC-8_3.9x4.9mm_P1.27mm

Connections:
+5V: C7.1, C8.1, U5.3 (VCC); also elsewhere on the board
/CAN/CAN_RX: U5.4 (RXD); also elsewhere on the board
/CAN/CAN_TX: U5.1 (TXD); also elsewhere on the board
GND: C6.2, C7.2, C8.2, D3.3 (A), U5.2 (GND), U5.8 (S); also elsewhere on the board
unnamed: C6.1, R2.2, R3.1
unnamed: D3.2 (K), J3.1, J4.2, R3.2, U5.6 (CANL)
unnamed: D3.1 (K), J3.2, J4.1, R2.1, U5.7 (CANH)

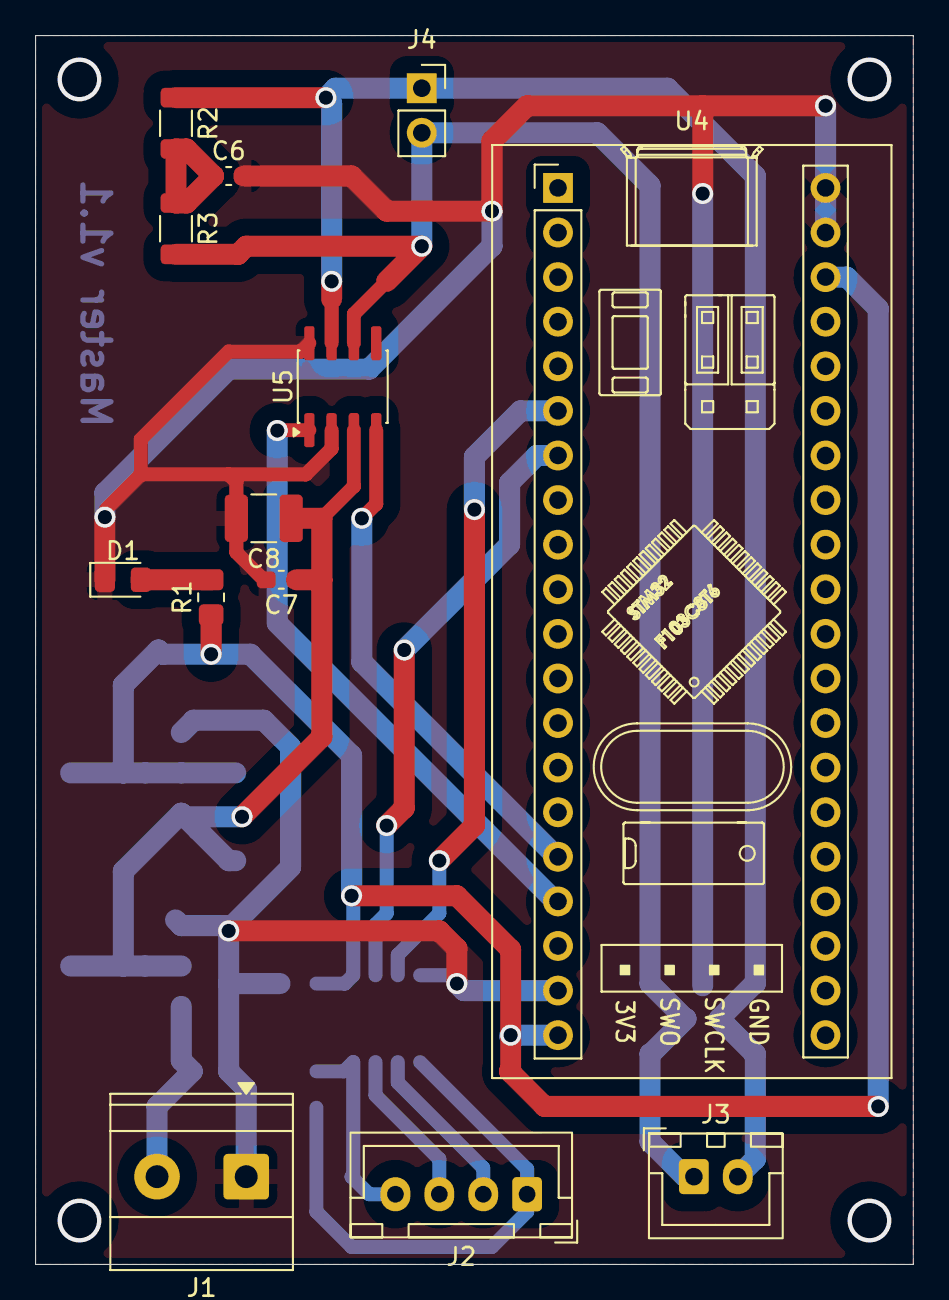
[picture p56: board MasterModule.kicad_pcb from above]

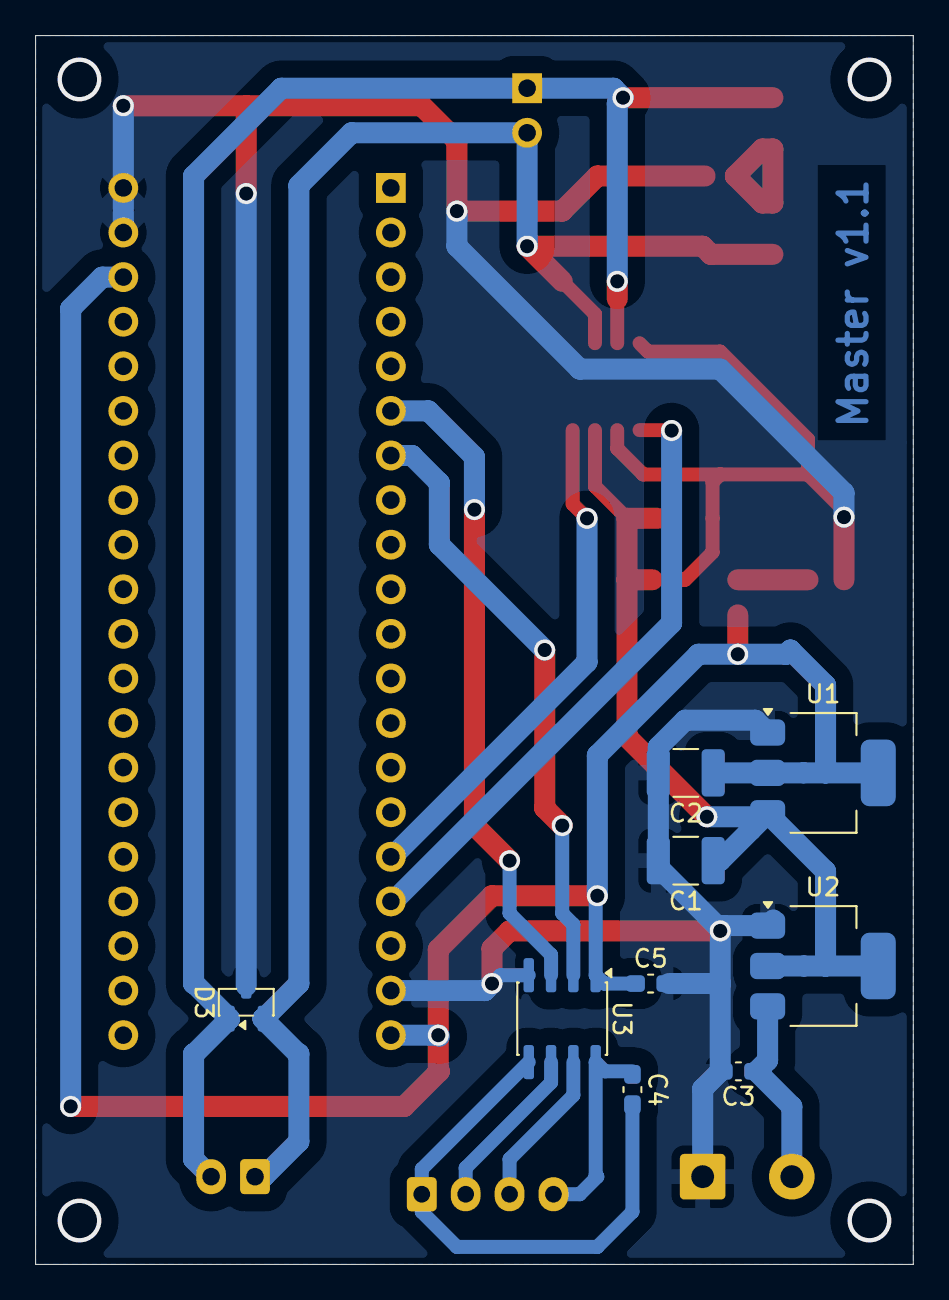
[picture p57: board MasterModule.kicad_pcb from below]

Board: 2 copper layers, 50.0 x 70.0 mm, 22 parts (9 on the bottom side), 16 nets.
