dmitry131131/PumpSystem/MasterModule/Core/Src/main.c

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
/* Includes ------------------------------------------------------------------*/
#include "main.h"

/* USER CODE BEGIN Includes */

#include "Device.h"
#include "BusConnection.h"
#include "BusConnectionConfig.h"
#include "FIFO.h"
#include "UART.h"
#include "UARTRuntime.h"
#include "CANRuntime.h"

/* USER CODE END Includes */

/* USER CODE BEGIN PD */
const uint32_t MY_ID = 100;
/* USER CODE END PD */

CAN_HandleTypeDef hcan;

UART_HandleTypeDef huart1;

/* USER CODE BEGIN PV */

uint32_t TxMailbox = 0;
uint32_t CAN_Error = 0;
HAL_StatusTypeDef HAL_Error;
fifo_t CANRxFIFO = NULL;

int RegisteredByMonitor = 0;  // TODO bool
UART_Message UARTRxTmpMessage = {};
UART_Message UARTTxTmpMessage = {};
fifo_t UARTRxFIFO = NULL;
fifo_t UARTTxFIFO = NULL;

// TODO Rewrite this to Hash Table
struct PumpList Pumps = {};

int NeedToUartActions = 0;
int NeedToCANAction = 0;

/* USER CODE END PV */

void SystemClock_Config(void);
static void MX_GPIO_Init(void);
static void MX_CAN_Init(void);
static void MX_USART1_UART_Init(void);
/* USER CODE BEGIN 0 */

void HAL_CAN_RxFifo0MsgPendingCallback(CAN_HandleTypeDef *can) {
  CANRxMessage NewMessage = {};

  if (HAL_CAN_GetRxMessage(can, CAN_RX_FIFO0, &NewMessage.Header, NewMessage.RxData) != HAL_OK) {
    return;
  }
  if (NewMessage.Header.StdId != MY_ID) {
    return;
  }
  if (NewMessage.Header.DLC < 1) {
    return;
  }

  // TODO check return value of fifo add
  fifo_add(CANRxFIFO, &NewMessage);
}

void HAL_CAN_ErrorCallback(CAN_HandleTypeDef *can) {
  CAN_Error = HAL_CAN_GetError(&hcan);
  // HAL_GPIO_WritePin(GPIOC, GPIO_PIN_13, GPIO_PIN_RESET);
}

void HAL_GPIO_EXTI_Callback(uint16_t GPIO_Pin)
{
  HAL_GPIO_TogglePin(GPIOC, GPIO_PIN_13);
  
  if(GPIO_Pin != GPIO_PIN_11) {
    return;
  }

  NeedToUartActions = 1;
}

void HAL_UART_RxCpltCallback(UART_HandleTypeDef *huart) {
  fifo_add(UARTRxFIFO, &UARTRxTmpMessage);

  HAL_UART_Receive_IT(&huart1, (uint8_t*) &UARTRxTmpMessage, sizeof(UART_Message));
}

void HAL_UART_TxCpltCallback(UART_HandleTypeDef *huart) {
  // if (!fifo_is_empty(UARTTxFIFO)) {
  //   // Pop already sent message from the TxFIFO
  //   fifo_discard(UARTTxFIFO, 1, E_FIFO_FRONT);
  // }
  // if (fifo_is_empty(UARTTxFIFO)) {
  //   return;
  // }

  // fifo_get(UARTTxFIFO, &UARTTxTmpMessage);
  // HAL_UART_Transmit_IT(&huart1, (uint8_t*) &UARTTxTmpMessage, sizeof(UART_Message));
}


/* USER CODE END 0 */

/**
  * @brief  The application entry point.
  * @retval int
  */
int main(void)
{

  /* MCU Configuration--------------------------------------------------------*/

  /* Reset of all peripherals, Initializes the Flash interface and the Systick. */
  HAL_Init();

  /* Configure the system clock */
  SystemClock_Config();

  /* Initialize all configured peripherals */
  MX_GPIO_Init();
  MX_CAN_Init();
  MX_USART1_UART_Init();
  /* USER CODE BEGIN 2 */

  PumpListInit(&Pumps, 16);
  CANRxFIFO = fifo_create(64, sizeof(CANRxMessage));

  // Create UART FIFOs
  UARTRxFIFO = fifo_create(64, sizeof(UART_Message));
  UARTTxFIFO = fifo_create(64, sizeof(UART_Message));

  CAN_FilterTypeDef sFilterConfig;
  sFilterConfig.FilterBank = 0;
  sFilterConfig.FilterMode = CAN_FILTERMODE_IDMASK;
  sFilterConfig.FilterScale = CAN_FILTERSCALE_32BIT;
  sFilterConfig.FilterIdLow = 0;
  sFilterConfig.FilterIdHigh = 0;
  sFilterConfig.FilterMaskIdLow = 0;
  sFilterConfig.FilterMaskIdHigh = 0;
  sFilterConfig.FilterFIFOAssignment = CAN_RX_FIFO0;
  sFilterConfig.FilterActivation = ENABLE;

  if (HAL_CAN_ConfigFilter(&hcan, &sFilterConfig) != HAL_OK) {
    Error_Handler();
  }

  HAL_Error = HAL_CAN_Start(&hcan);
  HAL_Error = HAL_CAN_ActivateNotification(&hcan, CAN_IT_RX_FIFO0_MSG_PENDING | CAN_IT_ERROR | CAN_IT_BUSOFF | CAN_IT_LAST_ERROR_CODE);

  /* USER CODE END 2 */

  /* Infinite loop */
  /* USER CODE BEGIN WHILE */

  HAL_GPIO_WritePin(GPIOC, GPIO_PIN_13, GPIO_PIN_SET);

  int UART_INIT = 0;

  // Start receiving UART messages
  HAL_UART_Receive_IT(&huart1, (uint8_t*) &UARTRxTmpMessage, sizeof(UART_Message));

  while (1)
  {
    /* USER CODE END WHILE */

    /* USER CODE BEGIN 3 */

    // Indicated Registration
    if (RegisteredByMonitor) {
      HAL_GPIO_WritePin(GPIOC, GPIO_PIN_13, GPIO_PIN_RESET);
    }

    // UART runtime
    UARTRuntime(&huart1, &hcan, UARTRxFIFO, UARTTxFIFO);

    // TODO Create CAN FIFO 
    // TODO Handle CAN error and CAN bus-off situations 
    // CAN runtime
    CANRuntime(&hcan, CANRxFIFO);
  }

  PumpListFree(&Pumps);
  /* USER CODE END 3 */
}

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
