dmitry131131/PumpSystem/MasterModule/MasterModule.ioc

Mcu.UserName=STM32F103C8Tx
PA10.Signal=USART1_RX
PA9.Signal=USART1_TX
PB11.Signal=GPXTI11
PB8.Signal=CAN_RX
PB9.Signal=CAN_TX
PC13-TAMPER-RTC.Signal=GPIO_Output
PD0-OSC_IN.Signal=RCC_OSC_IN
PD1-OSC_OUT.Signal=RCC_OSC_OUT
