dmitry131131/PumpSystem/PumpModule/include/Config.hpp

#pragma once

// A4988 pinout
const unsigned DIR_PIN    =  8;   // Pin DIR
const unsigned STEP_PIN   =  3;   // Pin STEP
const unsigned MS1_PIN    =  4;   // MS1
const unsigned MS2_PIN    =  5;   // MS2
const unsigned MS3_PIN    =  6;   // MS3
const unsigned ENABLE_PIN =  7;   // Pin ENABLE

// Engine settings 
const unsigned STEPS_PER_REV = 200;    // 200 steps per rotation (default NEMA17)

// Indication
const unsigned INDICATOR_PIN = 9;

// Safety switch
const unsigned FORWARD_SWITCH_PIN = 16;
const unsigned REVERSE_SWITCH_PIN = 15;

// MCP2515 pinout
const unsigned CS_PIN = 10; //  CS pin
const unsigned INT_PIN = 2; //  Interrupt pin

// CAN IDs
const uint8_t MASTER_ID = 100;
const uint8_t MY_ID = 101;
const unsigned MAX_REGISTRATION_RETRIES = 5;
const unsigned long RESPONSE_TIMEOUT = 1000;
