dmitry131131/PumpSystem/PumpModule/src/Rotation.cpp

#include <Arduino.h>
#include "Rotation.hpp"
#include "Config.hpp"

const unsigned long MINUTE = 60000000L; // Microseconds in 1 minute

namespace {
void impuls(int microseconds) {
    int impuls_duration = microseconds > 2 ? microseconds : 2; 

    digitalWrite(STEP_PIN, HIGH);
    delayMicroseconds(impuls_duration);
    digitalWrite(STEP_PIN, LOW);
}
}

// Fuction that enable rotation for the time miliseconds
void rotation(RotationDirection direction, unsigned RPM, double time) {
    digitalWrite(DIR_PIN, direction); // Set direction

    unsigned long impuls_period = MINUTE / (RPM * STEPS_PER_REV * get_microsteping_coeff());
    double current_time = 0;        // In miliseconds

    digitalWrite(ENABLE_PIN, LOW);  // Enable driver

    while (current_time < time) {
        impuls(10);
        delayMicroseconds(impuls_period);

        current_time += static_cast<double>(impuls_period) / 1000;
    }

    digitalWrite(ENABLE_PIN, HIGH);  // Disable driver
}

void rotation(RotationDirection direction, unsigned RPM) {
    digitalWrite(DIR_PIN, direction); // Set direction
    unsigned long impuls_period = MINUTE / (RPM * STEPS_PER_REV * get_microsteping_coeff());
    digitalWrite(ENABLE_PIN, LOW);  // Enable driver

    while (true) {    
        impuls(10);
        delayMicroseconds(impuls_period - 10);
    }

    digitalWrite(ENABLE_PIN, HIGH);  // Disable driver
}

// Rotate with 6 RPM by degree
void rotate(RotationDirection direction, double degree) {
    digitalWrite(DIR_PIN, direction);   // Set direction
    unsigned long impuls_period = MINUTE / (6 * STEPS_PER_REV * get_microsteping_coeff());
    digitalWrite(ENABLE_PIN, LOW);  // Enable driver

    size_t impuls_count = static_cast<unsigned>(degree * STEPS_PER_REV * get_microsteping_coeff() / 360);
    for (size_t i = 0; i < impuls_count; ++i) {
        impuls(10);
        delayMicroseconds(impuls_period - 10);
    }

    digitalWrite(ENABLE_PIN, HIGH);  // Disable driver
}

void rotate(RotationDirection direction, double degree, unsigned RPM) {
    digitalWrite(DIR_PIN, direction);   // Set direction
    unsigned long impuls_period = MINUTE / (RPM * STEPS_PER_REV * get_microsteping_coeff());
    digitalWrite(ENABLE_PIN, LOW);  // Enable driver

    size_t impuls_count = static_cast<unsigned>(degree * STEPS_PER_REV * get_microsteping_coeff() / 360);
    for (size_t i = 0; i < impuls_count; ++i) {
        impuls(10);
        delayMicroseconds(impuls_period - 10);
    }

    digitalWrite(ENABLE_PIN, HIGH);  // Disable driver
}

unsigned get_microsteping_coeff() {
  bool MS1 = digitalRead(MS1_PIN);
  bool MS2 = digitalRead(MS2_PIN);
  bool MS3 = digitalRead(MS3_PIN);

  unsigned combined = MS1 | MS2 << 1U | MS3 << 2U;

  switch (combined)
  {
  case 0:
    return 1;
  case 1:
    return 2;
  case 2:
    return 4;
  case 3:
    return 8;
  case 7:
    return 16;
  
  default:
    return 16;
  }
}

void set_microsteping_coeff(unsigned coeff) {
    switch (coeff)
    {
    case 1:
        digitalWrite(MS1_PIN, LOW);
        digitalWrite(MS2_PIN, LOW);
        digitalWrite(MS3_PIN, LOW);
        break;
    case 2:
        digitalWrite(MS1_PIN, HIGH);
        digitalWrite(MS2_PIN, LOW);
        digitalWrite(MS3_PIN, LOW);
        break;
    case 4:
        digitalWrite(MS1_PIN, LOW);
        digitalWrite(MS2_PIN, HIGH);
        digitalWrite(MS3_PIN, LOW);
        break;
    case 8:
        digitalWrite(MS1_PIN, HIGH);
        digitalWrite(MS2_PIN, HIGH);
        digitalWrite(MS3_PIN, LOW);
        break;
    case 16:
        digitalWrite(MS1_PIN, HIGH);
        digitalWrite(MS2_PIN, HIGH);
        digitalWrite(MS3_PIN, HIGH);
        break;
    
    default:
        // TODO error handler
        break;
    }
}
