dmitry131131/PumpSystem/(commit log)

2026-02-07 [Pump] Created basic functions for Pump module
2026-02-17 [Infra] Made pipeline for STM32 programming
2026-02-18 [CAN] Add Doesn't work CAN structure
    [MasterModule.ioc, main.c]
2026-02-24 [PumpModule][CAN] Add all libs and simple example with connection between STM32 and Arduino
2026-03-02 [PumpModule][3DModel] Add all mecanical part of PumpModule
    [BackMount.3mf, BackMount.stp, Carriage.3mf, Carriage.stp, CarriageHolder.3mf, CarriageHolder.stp, CarriageSlider.3mf, CarriageSlider.stp]
2026-03-02 [PumpModule][3DModel] Fix Carriage for new fastener
    [Carriage.stp]
2026-03-02 [PumpModule][Core] Add some rotation functions
2026-03-03 [PumpModule][Core] write registration code for PumpModule
2026-03-04 [PumpModule][CAN] Add registration code for PumpModule
2026-03-07 [MasterModule][CAN] Add code for MasterModule to make Pump registration process possible
2026-03-07 [MasterModule][CAN] Add Message types and Pump Registration protocol
2026-03-08 [CAN] Add stable commands and data transmission between PumpModules and Master
2026-03-10 [CAN] Realized full CAN messaged in Pump
2026-03-17 [UART] Add monitor program basic structure and add Uart protocol functions
2026-03-20 [UART] Add UART runtime to MasterModule. Refactor UART_message ctor in Monitor
2026-03-22 [UART] Made working system with monitor, master and pump
2026-04-01 [Monitor] Add whole system working (with huge bugs) showed to customer
    [CANRuntime.c, GUI.cpp, GUI.hpp, Pump.hpp, PumpMonitor.cpp, PumpMonitor.hpp, UART.cpp, UART.hpp]
2026-04-08 [MasterModule][PCB] Create PCB for Bus part of Master module
    [BusModule.kicad_pcb, BusModule.kicad_sch]
2026-04-23 [MasterModule][PCB] Add full traced BUS circuit board
    [BusModule.kicad_pcb]
2026-04-29 [BUS][PCB] Fix chipboard size
    [BusModule.kicad_pcb]
2026-05-18 Actual master module CAD
    [Главная деталь корпуса.3mf, Главная деталь корпуса.stp, Крышка.3mf, Крышка.stp, Под провода.3mf, Под провода.stp, Прижим для UART.stp]
2026-05-24 [BUS][PCB] Made PCB template for manufacturing
    [BusModule.kicad_pcb, BusModule.kicad_sch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]
2026-05-28 [PCB][Bus] Add GND and 12V poligon (Bus v1.1)
    [BusModule.kicad_pcb, BusModule.kicad_sch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]
2026-06-05 [BUS] Add coper fields
    [BusModule.kicad_pcb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]
2026-06-09 [PumpModule][PCB] Create Board for PumpModule electronic
    [MCP2515Module.kicad_sch, PowerUnit.kicad_sch, PumpModule.kicad_pcb, PumpModule.kicad_sch]
2026-06-09 [PCB][Pump Module] Fixed PCB pinout
    [PumpModule.kicad_sch]
2026-06-09 [PCB] Made Pump v1.0 PCB
    [PumpModule.kicad_pcb, PumpModule.kicad_sch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]
2026-06-09 [PCB][PumpModule] Fixed input power pinout. Changed indication pin and add status LED to A0 pin
    [PumpModule.kicad_pcb, PumpModule.kicad_sch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]
2026-06-09 [PCB][BUS] Fix power connections plates (v 1.2)
    [BusModule.kicad_pcb]
2026-06-11 [PCB][MasterModule] Add PCB width and height and add basic elements
    [MasterModule.kicad_pcb, MasterModule.kicad_sch, Power_unit.kicad_sch, UART_galvanic_isolation.kicad_sch]
2026-06-13 [PCB][PumpModule] Add manufacturing files
    [PumpModule.kicad_pcb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]
2026-06-14 [PCB][MasterModule] Create MasterModule v.1.0
    [CAN.kicad_sch, MasterModule.kicad_pcb, MasterModule.kicad_sch, UART_galvanic_isolation.kicad_sch]
2026-06-15 [PCB][MasterModule] Manufactured master module v1.0
    [MasterModule.kicad_pcb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]
2026-06-17 [PCB][MasterModule] Fix CAN transmitter to TJA1050 chip (Master v1.1)
    [CAN.kicad_sch, MasterModule.kicad_pcb, Power_unit.kicad_sch, UART_galvanic_isolation.kicad_sch]
2026-07-11 [MasterModule][PCB] Create master v1.1 manufacturing files
    [MasterModule.kicad_pcb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]
2026-07-11 [PumpModule][3D] Add electric box model
2026-07-12 [PumpModule][3D] Add Electric box cap
    [Корпус для электроники.3mf, Корпус для электроники.stp, Крышка корпуса для электроники.3mf, Крышка корпуса для электроники.stp]
2026-07-20 [PumpModule][3D] Add electric box and add magnetic system
    [Assembly_magnetic.stp, BackMount_magnetic.3mf, BackMount_magnetic.stp, CableChannelHolder.stp, Carriage_magnetic.3mf, Carriage_magnetic.stp, MagneticSyringeHolder.3mf, MagneticSyringeHolder.stp]
2026-07-20 [Infra] Add gitignore to BUS, MasterModule and Pump
2026-07-29 [PumpModule][PCB] Add Switch v1.2
    Switch PCB for PumpModule contains switches on both sides and
    3-pin JST-XH connector. Switch shorts to GND if limit reached
    [PumpModule][PCB] Add switch v1.0 Manufacturing
    [PumpModule][PCB] Fix GND polygon in Switch v1.0
    [PumpModule][PCB] Updated switches to SW10 create Switch v1.1
    [PumpModule][PCB] Manufactured 12 Switch v1.1 PCB and fixed routing (switch v1.2)
    [Switch.kicad_pcb, Switch.kicad_sch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]
2026-08-02 [PumpModule][3D] Fix stopper 3d model to fit switch on carriage
2026-08-02 [PumpModule][3D] Add gitignore, fix file naming, delete useless files
    [Assembly_magnetic.stp, HeadHinge.STEP, Hinge.STEP, TailHinge.STEP, backSupport.stl, carriage.stl, carriage_lm8uu.stl, coupling.stl]
2026-08-02 [PumpModule][3D] Remove useless files to NotMagnitized directory
    [BackMount.3mf, BackMount.stp, BackMount_magnetic.3mf, BackMount_magnetic.stp, CableChannelHolder.stp, Carriage.3mf, Carriage.stp, CarriageHolder.3mf]
2026-08-02 [PumpModule][3D] Made minufacturing files
    [BackMount_magnetic.stp, CableChannel.3mf, CableChannelHolder.stp, Carriage_magnetic.stp, ElectricBox.3mf, ElectricBox.stp, ElectricBoxCup.stp, EngineMount.stp]
2026-08-04 [PumpModule][3D] Fixed manufacturing files
    [MainParts.3mf, SupportingElements.3mf]
2026-08-06 [PumpModule][3D] Fix ElectricBoxCup
    [ElectricBox.3mf, ElectricBoxCup.stp, SupportingElements.3mf]
2026-08-27 [PumpModule][3D] Fix stopper and electric box model. Add BoltCap 3d model
    [BoltCap.3mf, BoltCap.stp, ElectricBox.3mf, ElectricBox.stp, Stoper.stp, SupportingElements.3mf]
2026-08-27 [PumpModule][PCB] Fix PumpModule PCB pins
    [PumpModule.kicad_pcb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]
2026-09-05 [PumpModule][3D] Finilized 3D models for assembly
    [BoltCap.3mf, BoltCap.stp, Stoper.3mf]
